rusefi/hellen121vag/README.md

A member of [Hellen ECU family](https://github.com/andreika-git/hellen-one) for [rusEFI firmware](https://github.com/rusefi/rusefi).

[User Documentation](https://github.com/rusefi/rusefi/wiki/Hellen121VAG)

ME 7.5
