rusefi/hellen121vag/boards/hellen121vag-a/board/misc/hellen121vag-a-bottom.png

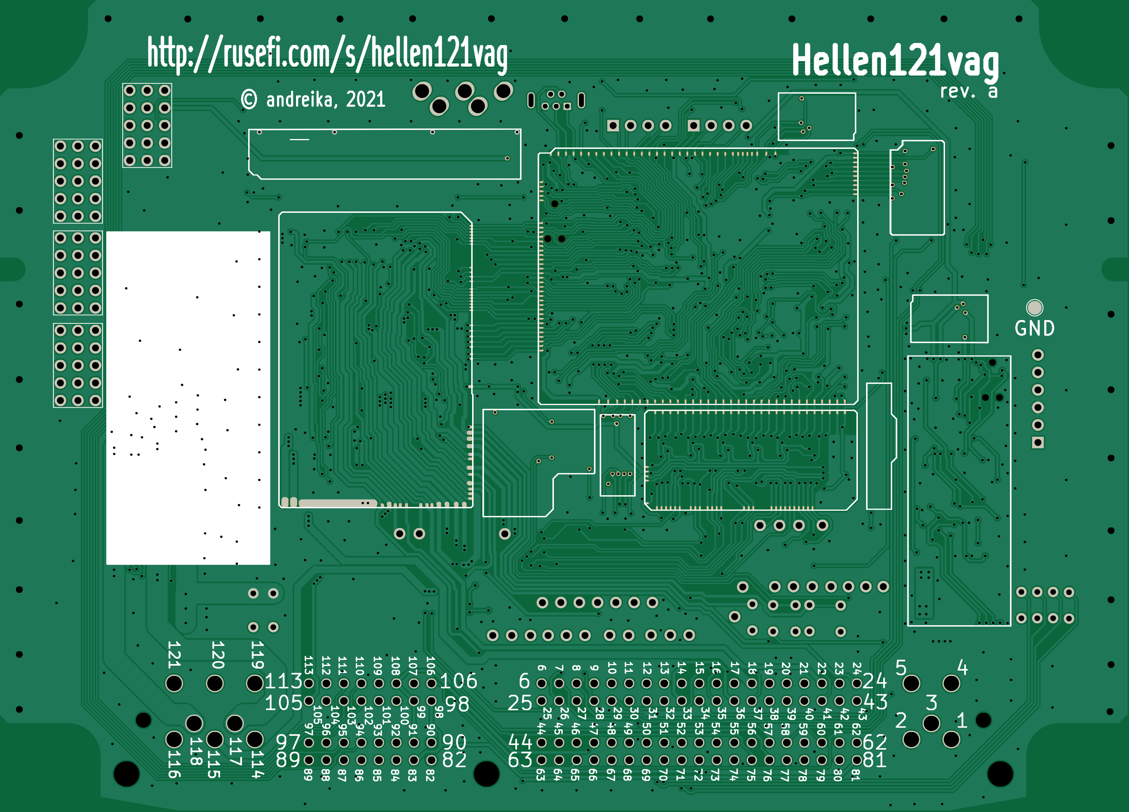
boards/hellen121vag-a/board/misc/hellen121vag-a-bottom.png
