rusefi/hellen121vag/boards/hellen121vag-a/board/Produce_DanZhi.SMT_Original_Snapshot.Top.2582135A_Y99.SMT0210502188446.png

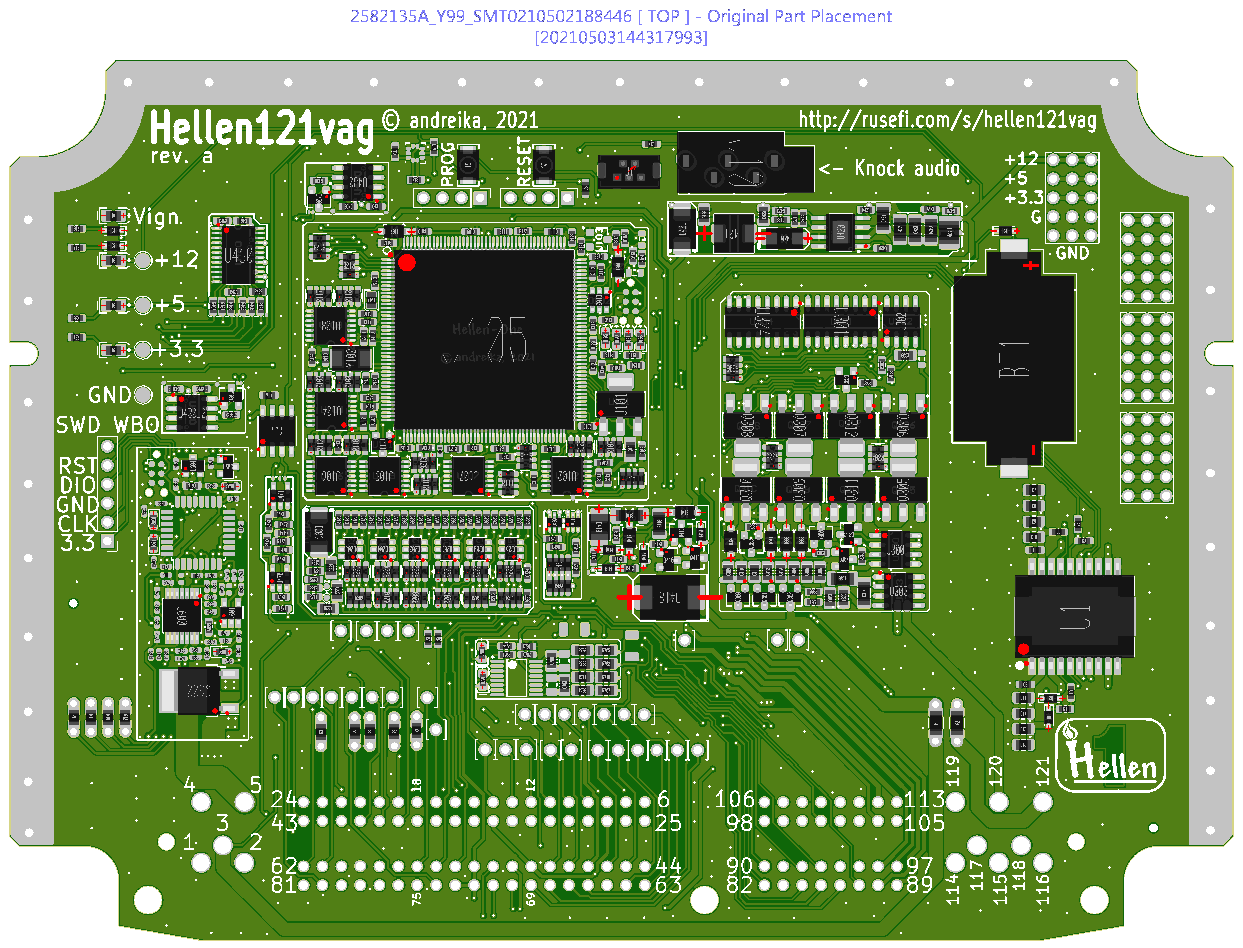
boards/hellen121vag-a/board/Produce_DanZhi.SMT_Original_Snapshot.Top.2582135A_Y99.SMT0210502188446.png
