rusefi/hellen121vag/boards/hellen121vag-b/board/hellen121vag-b.png

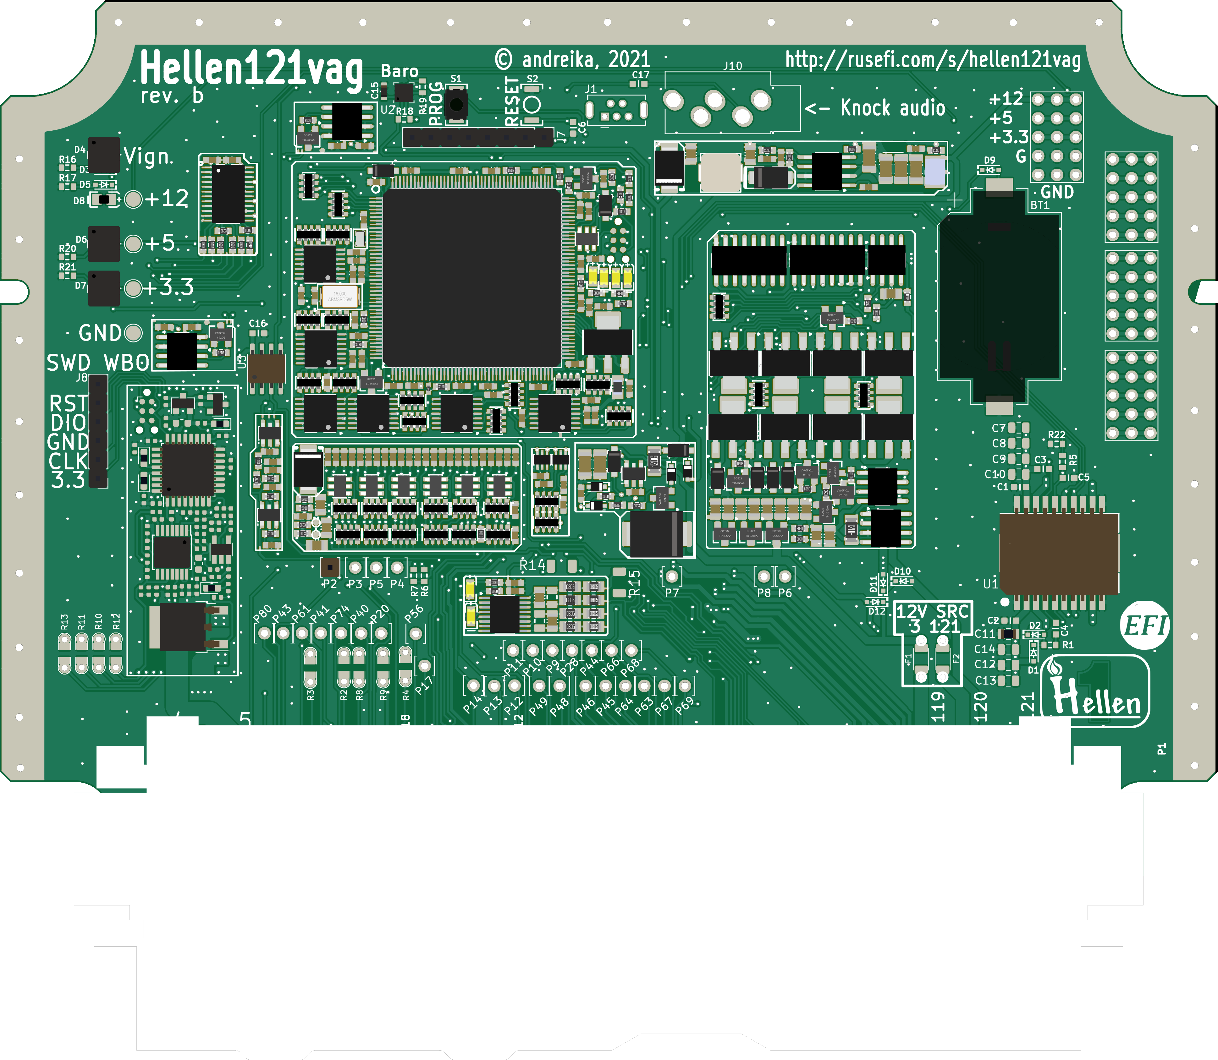
boards/hellen121vag-b/board/hellen121vag-b.png
