rusefi/hellen121vag/boards/hellen121vag-b/board/misc/hellen121vag-b-outline.png

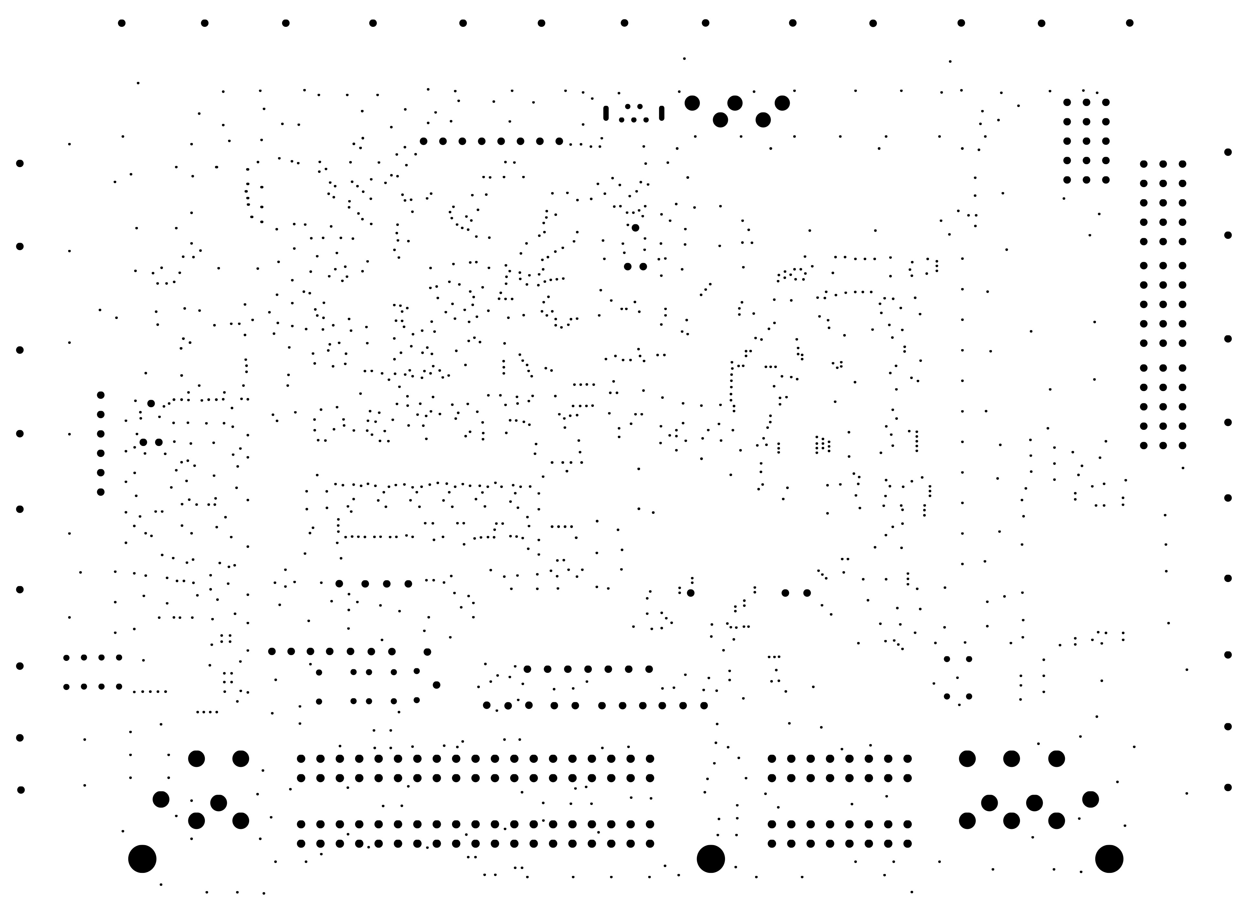
boards/hellen121vag-b/board/misc/hellen121vag-b-outline.png
