rusefi/hellen121vag/boards/hellen121vag-b/board/Produce_DanZhi.SMT_Snapshot.Top.2582135A_Y102.SMT0210614213996.png

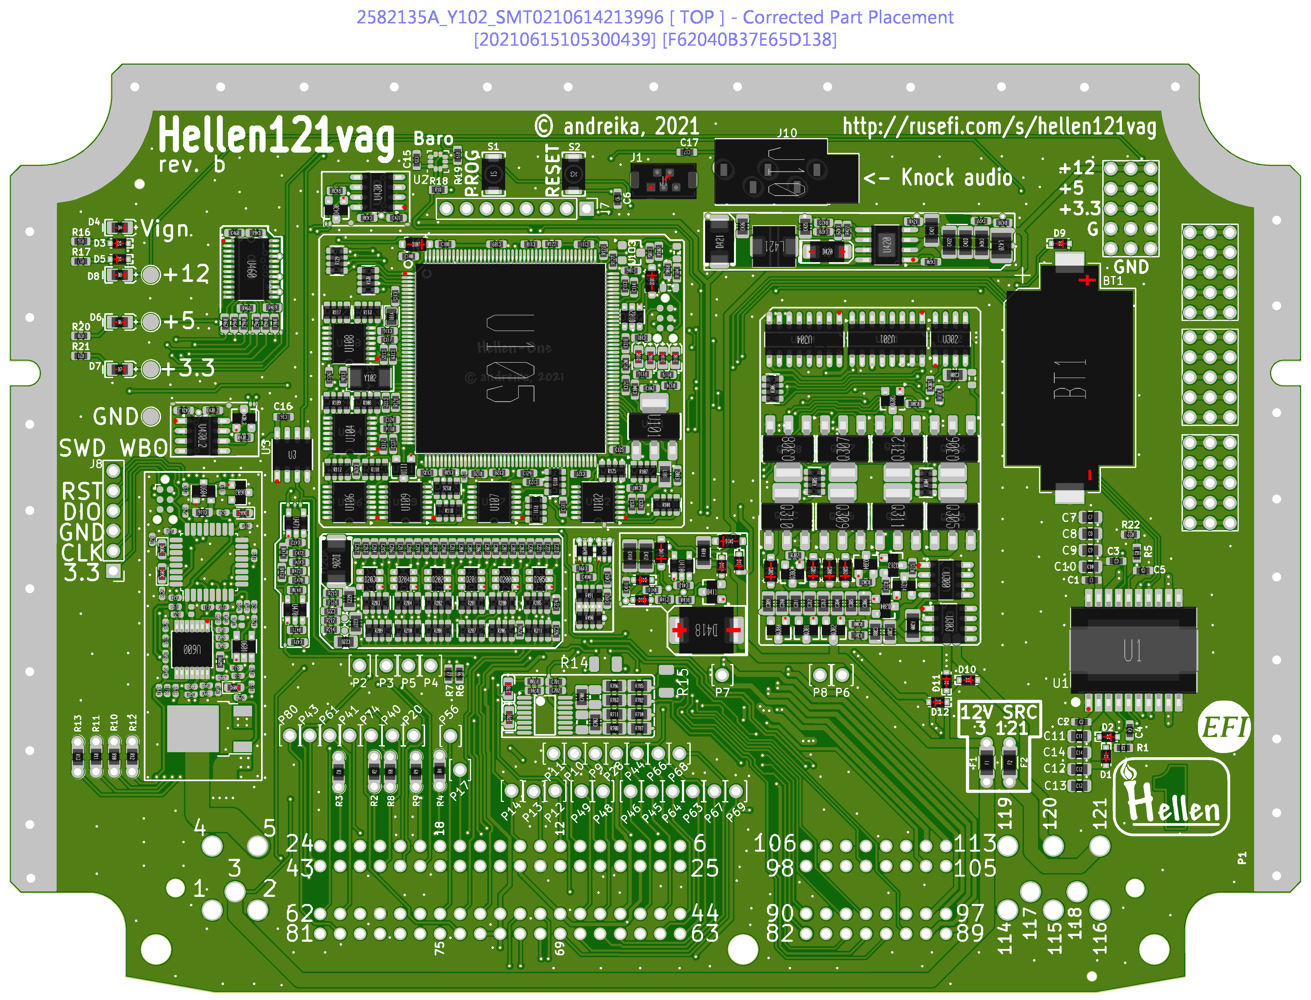
boards/hellen121vag-b/board/Produce_DanZhi.SMT_Snapshot.Top.2582135A_Y102.SMT0210614213996.png
