rusefi/hellen121vag/boards/hellen121vag-c/board/hellen121vag-c.png

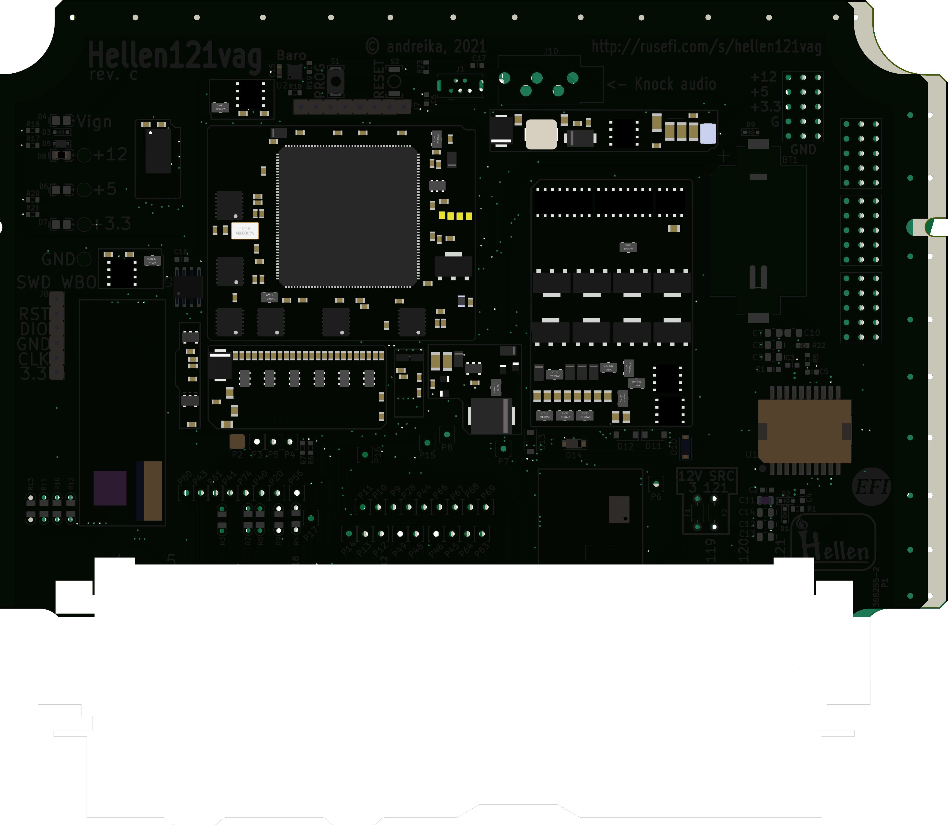
boards/hellen121vag-c/board/hellen121vag-c.png
