rusefi/hellen121vag/boards/hellen121vag-c/board/misc/hellen121vag-c-top.png

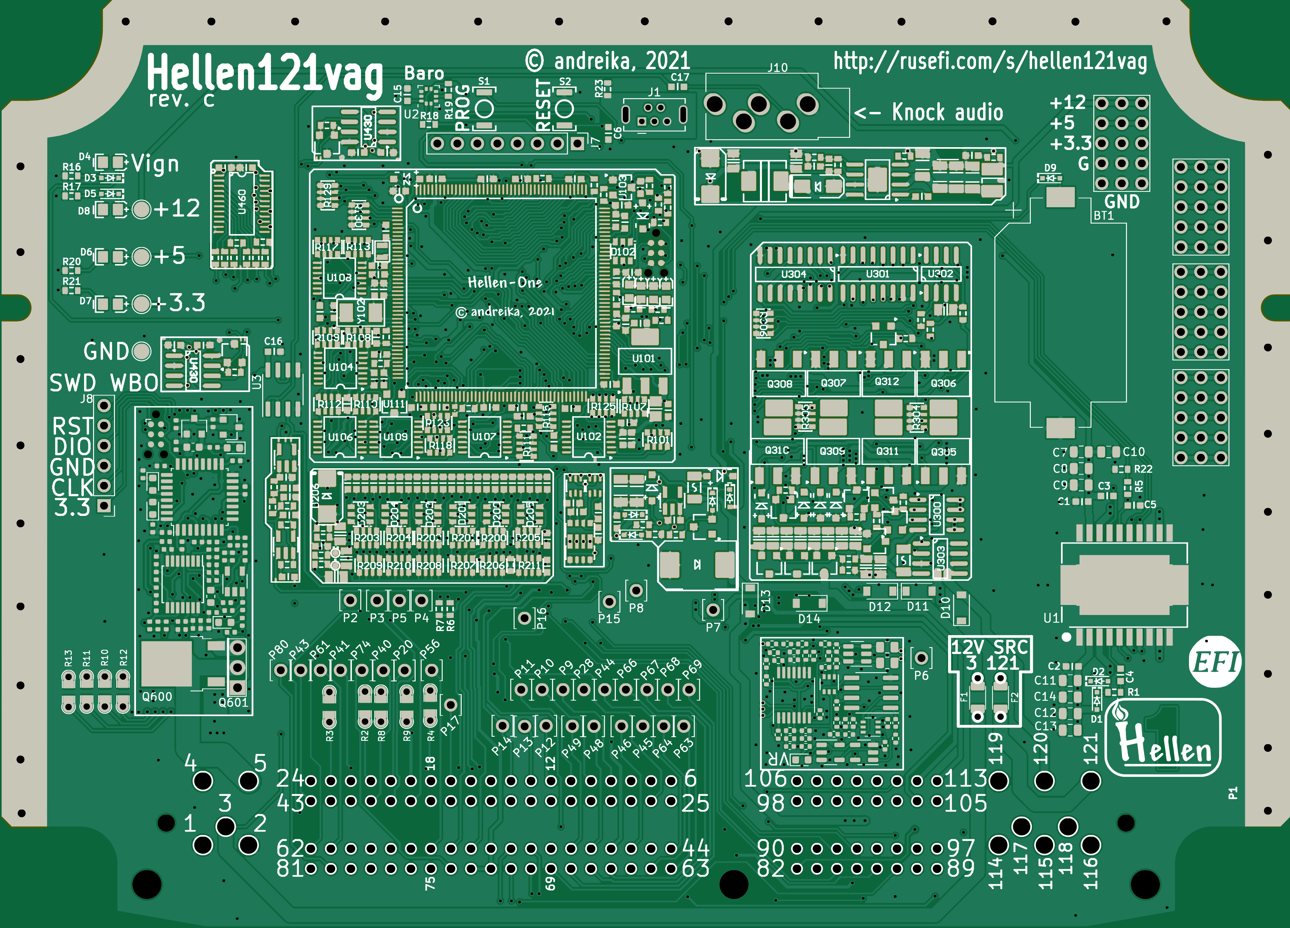
boards/hellen121vag-c/board/misc/hellen121vag-c-top.png
