rusefi/hellen121vag/boards/hellen121vag-c/board/Produce_DanZhi.SMT_Original_Snapshot.Top.211012.png

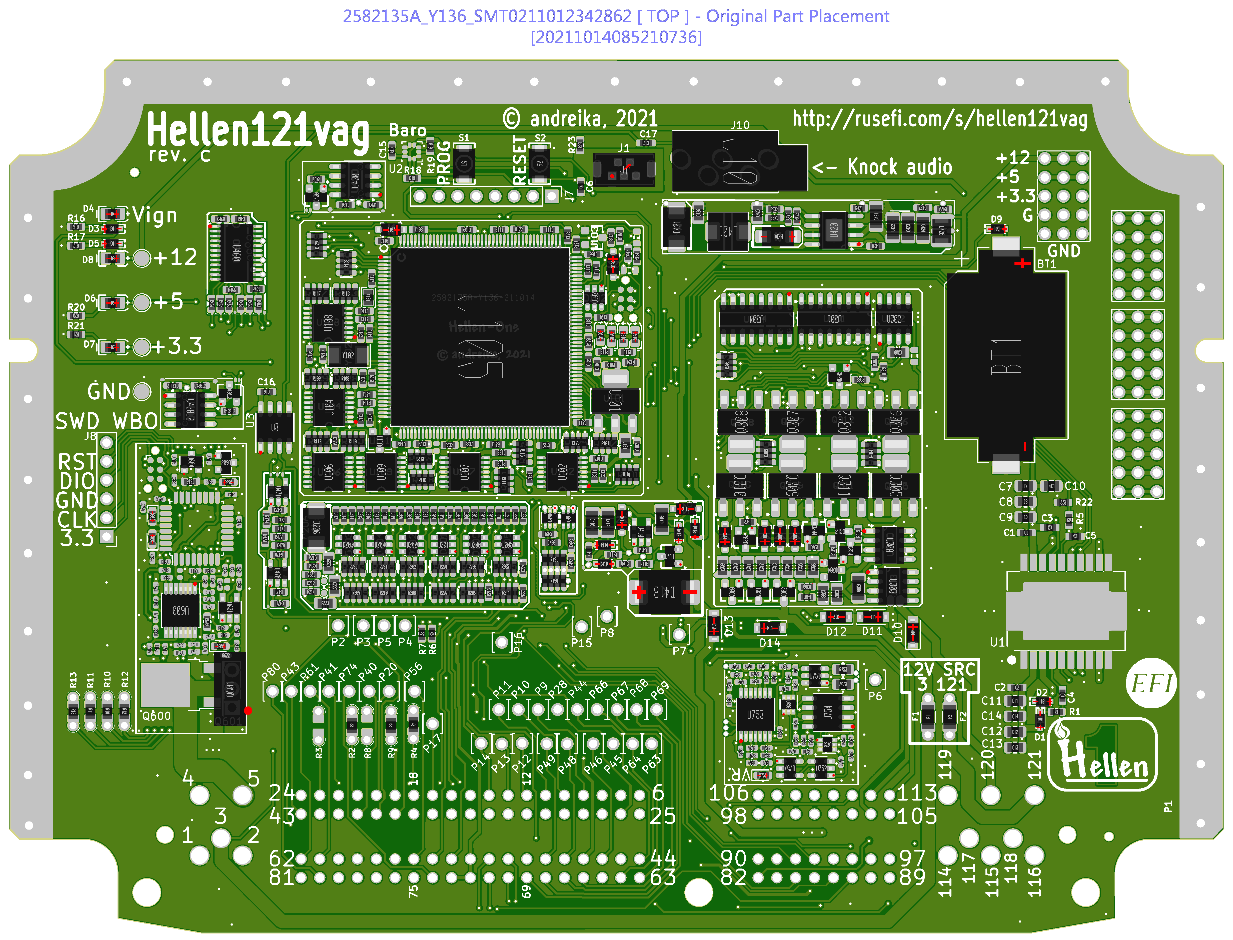
boards/hellen121vag-c/board/Produce_DanZhi.SMT_Original_Snapshot.Top.211012.png
