rusefi/hellen121vag/boards/hellen121vag-b/board/hellen121vag-b-BOM.14june2021.csv

Comment | Designator | Footprint | LCSC Part #
BATTERY_CR2032 | BT1 | BATTERY-2032 | C70377
100n | C1, C2, C6, C15, C16, C430, C431, C420, C101, C105, C106, C107, C108, C109, C110, C111, C112, C113, C117, C118, C119, C120, C121, C122, C123, C124, C125, C126, C127, C128, C129, C130, C135, C139, C204, C205, C206, C207, C212, C213, C214, C215, C220, C221, C222, C223, C224, C225, C226, C470, C460, C461, C411, C413, C430_2, C431_2, C702 | C0603 | C14663
220n | C3 | C0603 | C21120
10n | C4 | C0603 | C100042
5.6n | C5 | C0603 | C170143
10u | C7, C8, C9, C10, C11, C12, C13, C14, C425, C426, C300, C304, C305, C306, C307, C308, C309, C310, C311, C312, C313 | C0805 | C15850
10u | C17, C701 | C0603 | C19702
1N4148WS | D1, D2, D3, D5, D9, D10, D11, D12, D410, D412, D413, D414 | SOD-323 | C2128
LED-GREEN-0805 | D4, D6, D7, D8 | LED-0805 | C2297
Fuse-Pad-Pad | F1, F2 | PAD-1206-PAD | C182446
PROTO_AREA | G1 | PROTO_AREA
PROTO_AREA | G2 | PROTO_AREA
PROTO_AREA | G3 | PROTO_AREA
DISCLAIMER | G4 | Off_Road_Disclaimer
PROTO_AREA | G5 | PROTO_AREA
LOGO | G6 | LOGO
LOGO | G7 | LOGO
USB_B_Mini | J1 | USB-MINI-B-VERTICAL | C13453
Conn_01x01 | J2 | TestPoint_Pad_D2.0mm
Conn_01x01 | J3 | TestPoint_Pad_D2.0mm
Conn_01x01 | J4 | TestPoint_Pad_D2.0mm
Conn_01x01 | J5 | TestPoint_Pad_D2.0mm
Conn_01x01 | J6 | TestPoint_Pad_D2.0mm
Conn_01x08 | J7 | PinHeader_1x08_P2.54mm_Vertical
Conn_01x06 | J8 | PinHeader_1x06_P2.54mm_Vertical
AudioJack_THR | J10 | Jack_3.5mm_PJ-3250-5A | C165947
368255-2 | P1 | 368255-2
Pad | P2 | PAD-TH
Pad | P3 | PAD-TH
Pad | P4 | PAD-TH
Pad | P5 | PAD-TH
Pad | P6 | PAD-TH
Pad | P7 | PAD-TH
Pad | P8 | PAD-TH
Pad | P9 | PAD-TH
Pad | P10 | PAD-TH
Pad | P11 | PAD-TH
Pad | P12 | PAD-TH
Pad | P13 | PAD-TH
Pad | P14 | PAD-TH
Pad | P17 | PAD-TH
Pad | P20 | PAD-TH
Pad | P28 | PAD-TH
Pad | P40 | PAD-TH
Pad | P41 | PAD-TH
Pad | P43 | PAD-TH
Pad | P44 | PAD-TH
Pad | P45 | PAD-TH
Pad | P46 | PAD-TH
Pad | P48 | PAD-TH
Pad | P49 | PAD-TH
Pad | P56 | PAD-TH
Pad | P61 | PAD-TH
Pad | P63 | PAD-TH
Pad | P64 | PAD-TH
Pad | P66 | PAD-TH
Pad | P67 | PAD-TH
Pad | P68 | PAD-TH
Pad | P69 | PAD-TH
Pad | P74 | PAD-TH
Pad | P80 | PAD-TH
100 | R1, R104, R106 | R0603 | C22775
Jumper-Pad-Pad | R2, R4, R9, R10, R11, R12, R13 | PAD-0805-PAD | C17477
Jumper-Pad-Pad | R3, R8 | PAD-0805-PAD | C17477
100k | R5, R471, R473 | R0603 | C25803
2.7k | R6, R7 | R0603 | C13167
DNP | R14 | R1206
DNP | R15 | R1206
5.1k | R16, R17 | R0603 | C23186
4.7k | R18, R19, R302, R303, R307, R308, R313 | R0603 | C23162
1.6k | R20 | R0603 | C22847
750 | R21 | R0603 | C23241
10k | R22, R421, R102, R121, R122, R123, R127, R128, R300, R301, R315, R700, R701 | R0603 | C25804
Button_SPST | S1, S2 | SMD-2_2.9x3.9x1.7 | C115357
L6205PD | U1 | SO20POWER | C36543
LPS25HB | U2 | HLGA-10 | C87898
MCP6002-xSN | U3 | SO8 | C7377
PESD1CAN | D430, D430_2 | SOT-23 | C343993
120 | R430, R430_2 | R0603 | C22787
TJA1051T/3/1J | U430, U430_2 | SO8 | C38695
10u | C421, C422, C423, C424 | C1206 | C13585
4.7u | C427, C102, C103, C104, C137, C138, C140, C616 | C0603 | C19666
10n | C428, C201, C208, C209, C210, C211 | C0603 | C57112
220p | C429 | C0603 | C1603
SS34 | D420 | SMA | C8678
P6SMB6.8CA | D421, D206 | SMB | C78395
2.2uH | L420 | L1210 | C89016
1 | R420 | R0603 | C22936
68k | R422 | R0603 | C23231
12k | R423, R472 | R0603 | C22790
2.2u | C114, C131 | C0603 | C23630
12p | C115, C116 | C0603 | C38523
18p | C132, C136 | C0603 | C1647
B5819W | D101, D107, D300, D301, D302, D303, D416, D417 | SOD-123 | C8598
SRV05-4-P-T7 | D102, D200, D201, D202, D203, D204, D205 | SOT23-6 | C85364
LED-RED-0603 | D103, D600, D603, D700, D701 | LED-0603 | C2286
LED-GREEN-0603 | D104, D601 | LED-0603 | C72043
LED-BLUE-0603 | D105, D602 | LED-0603 | C72041
LED-YELLOW-0603 | D106 | LED-0603 | C72038
SDFL2012Q3R3KTF | L101 | L0805 | C51725
4.7k | R101, R107, R108, R109, R110, R111, R112, R113, R115, R117, R118, R125, R126 | R0603-4 | C66697
47 | R114 | R0603 | C23182
510 | R116, R119, R120, R124, R212, R213, R214, R215 | R0603 | C23193
10k | R129, R130, R208, R210, R304, R305, R306, R491 | R0603-4 | C29718
0 | R131 | R0402 | C17168
AMS1117-3.3 | U101 | SOT-223 | C6186
LMV324IPWR | U102, U104, U106, U107, U108, U109 | TSSOP14 | C398929
AP2337SA-7 | U103 | SOT-23 | C150497
XC6206P332MR | U111, U604 | SOT-23 | C5446
32.768 kHz | Y101 | SMD2012 | C99009
8.0 MHz | Y102 | SMD5032 | C115962
1n | C200, C202, C203, C216, C217, C218, C219, C490, C491, C492, C493 | C0603 | C1588
2.2u | C227, C228, C229 | C0805 | C49217
4.7k | R200, R201, R202, R203, R204, R205, R207 | R0603-4 | C1980
680k | R206, R209, R211, R490 | R0603-4 | C145776
3.3k | R216 | R0603 | C22978
3.3n | C471 | C0603 | C1613
330p | C472 | C0603 | C1664
47p | C473 | C0603 | C1671
680p | C474 | C0603 | C1630
470k | R470 | R0603 | C23178
33k | R474, R411 | R0603 | C4216
LMV321IDBVR | U470, U471 | SOT23-5 | C7972
PSM712-LF | D304, D305, D411 | SOT-23 | C32677
PJM2319PSA | Q300, Q301, Q302, Q303, Q304, Q313, Q314 | SOT-23 | C411720
0 | R310 | R0603 | C21189
RZ7899 | U300, U303 | SO8 | C92373
ULN2003AD | U301, U304 | SOIC16 | C7512
TC4427 | U302 | SO8 | C20551
10 | R461, R462, R463, R464, R466, R467, R468, R469 | R0603 | C22859
SN74LVC4245APWR | U460 | TSSOP24 | C7859
47u | C410, C412 | C1206 | C96123
SMCJ30A | D418 | SMC | C310046
6.8k | R410, R413 | R0603 | C23212
MIC5205-3.3YM5 | U410 | SOT23-5 | C37970
1u | C600, C607, C609, C610, C611 | C0402 | C52923
100n | C601, C602, C605, C608, C612, C613, C614, C615 | C0402 | C1525
33n | C603 | C0402 | C1585
DNP | C604 | C0402
DNP | C606 | C0402
BTS3028 | Q600 | DPAK | C112639
1k | R600, R601, R616, R617, R622, R626, R627, R628 | R0402 | C11702
68k | R602, R603 | R0402 | C36871
10k | R604, R605, R613, R614, R618, R619, R625 | R0402 | C25744
10 | R606 | R0402 | C25077
22k | R607 | R0402 | C25768
47 | R608 | R0402 | C25118
61.9 | R609 | R0603 | C23092
20k | R610, R611, R612 | R0402 | C25765
100k | R615, R621 | R0402 | C25741
27k | R620, R623 | R0402 | C25771
3.3k | R624 | R0402 | C25890
MCP6004 | U600 | TSSOP14 | C50282
AD8628 | U601 | TSOT23-5 | C29309
STM32F042K6Tx | U602 | LQFP32 | C69216
1n | C700, C703 | C0805 | C46653
5.1k | R702, R703, R705, R706, R707, R708, R710, R711 | R0805 | C27834
MAX9926 | U700 | QSOP16
74HC2G17GW | U490, U491 | SOT-363 | C94189
STM32F407IGT6 | U105 | LQFP176 | C33993
MWSA0503S-100MT | L421 | SMD-5.2x5.4x2.8 | C408412
LMR14030 | U420 | SOP8 | C182078
ZXMS6005SGTA | Q305, Q306, Q307, Q308, Q309, Q310, Q311, Q312 | SOT-223 | C174042
nSMD050-24V | F410, F300 | F1206 | C70076
REF3333AIDBZR | U603 | SOT-23 | C130016
