rusefi/hellen121vag/boards/hellen121vag-b/board/misc/hellen121vag-b-components.png

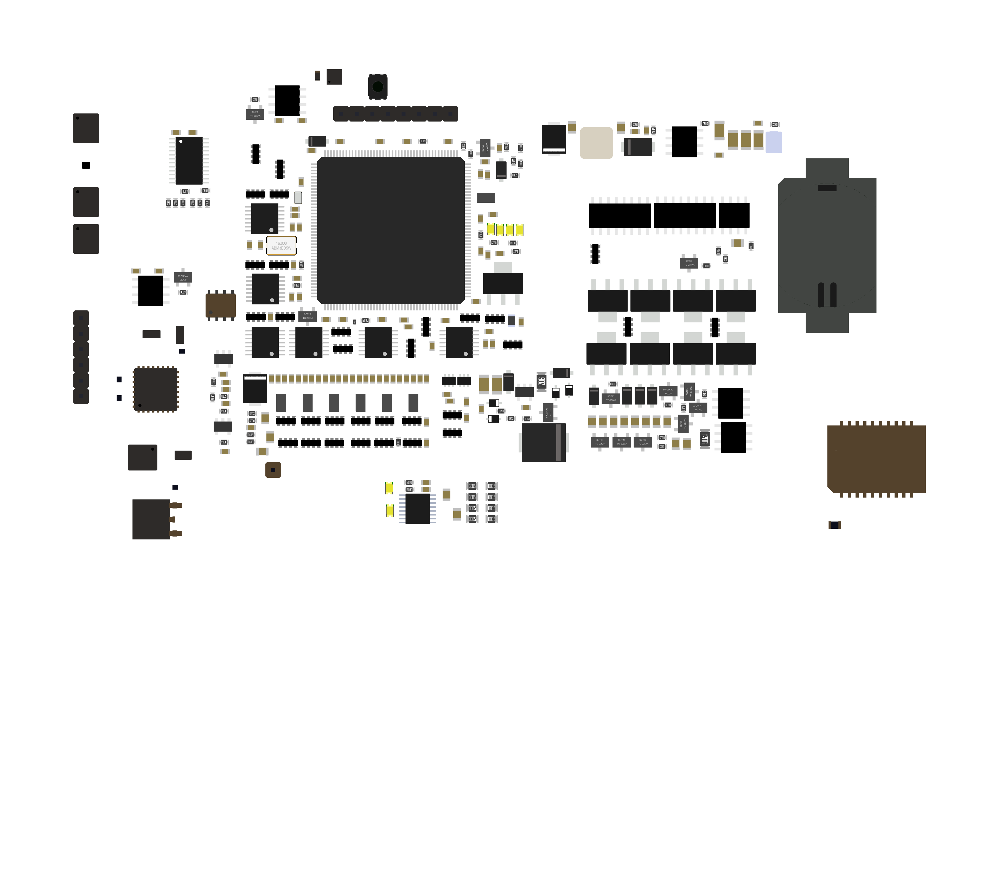
boards/hellen121vag-b/board/misc/hellen121vag-b-components.png
