rusefi/hellen121vag/boards/hellen121vag-c/board/misc/hellen121vag-c-components.png

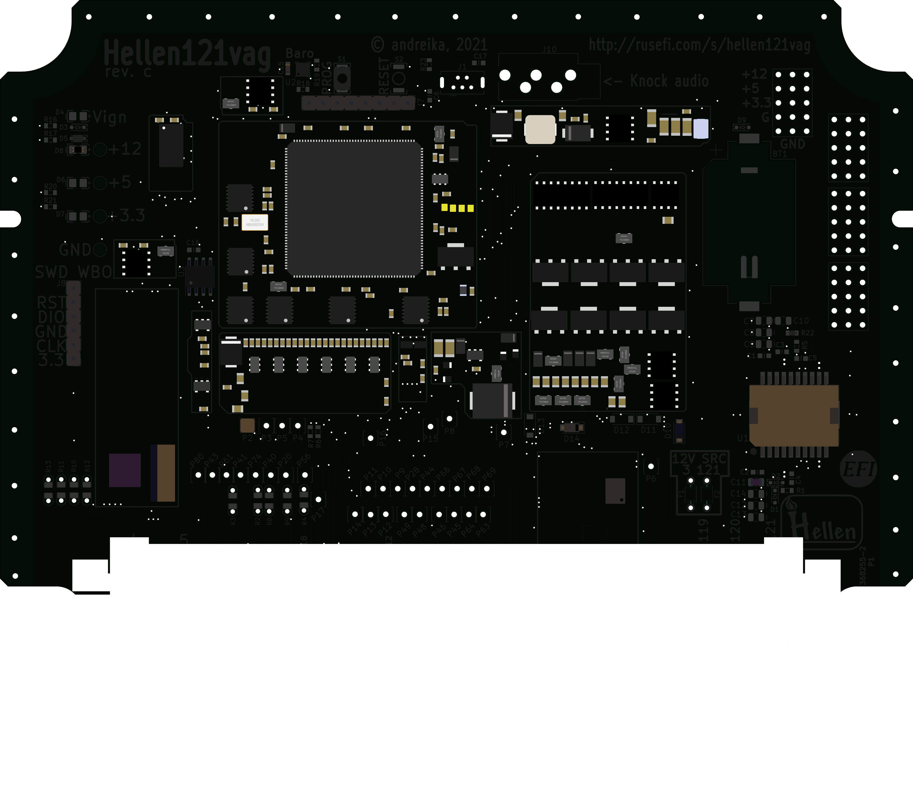
boards/hellen121vag-c/board/misc/hellen121vag-c-components.png
