rusefi/hellen121vag/releaseNotes.md

rev C:
    Crank/cam test points
    improved routing
    discrete VR 

rev B: 2021
    CLT/IAT pull-up fix

rev A: May 2, 2021
    Initial release
