rusefi/hellen121vag/(threads)

Thread 1 (2021-02-04):

WBO analysis

rusefillc, 2021-02-04:
Question: what cases do we have on VAG in terms of number of narrow band sensors and number of wide band sensors per vehicle?

Is there a clearly universal set of pins for a wideband or would we have to have options and jumpers?

rusefillc, 2021-03-08:
nice diagrams do not spell which pin is what function of WBO :(

https://github.com/rusefi/rusefi/wiki/OEM-Docs/VAG/2005_a4_1.8t_1.png

https://github.com/rusefi/rusefi/wiki/OEM-Docs/VAG/2005_a4_1.8t_2.png

https://github.com/rusefi/rusefi/wiki/OEM-Docs/VAG/2005_a4_1.8t_3.png

rusefillc, 2021-03-09:
Damn it's 4.2 :(

See https://rusefi.com/forum/viewtopic.php?p=40079#p40079

rusefillc, 2021-06-13:
@mck1117 any chance to have https://github.com/mck1117/wideband/issues/7 ?

if not we should add an un-populated jumper to make the board safer on arrival

rusefillc, 2021-06-15:
Status update: we know 4.2 pinout but we do not have 4.2 firmware

rusefillc, 2022-10-14:
@mck1117 @dron0gus where shall we place what unpopulated jumper to make the board safer while no 4.2 firmware?

mck1117, 2022-10-17:
do we need to? the existing controller hw+sw will not hurt a 4.2 sensor, it just won't work

Thread 5 (2021-02-19):

short URL label

rusefillc, 2021-02-19:
please place http://rusefi.com/s/hellen121vag on the board

Closed 2021-02-21.

Thread 8 (2021-03-12):

This board uses module rotation

andreika-git, 2021-03-12:
We need to implement module rotation in Hellen-One scripts in order to produce this board.
See https://github.com/andreika-git/hellen-one/issues/16

rusefillc, 2021-04-11:
This was fixed by https://github.com/andreika-git/hellen-one/issues/16

Closed 2021-04-11.

Thread 9 (2021-03-15):

hellen121vag rev A roadmap

rusefillc, 2021-03-15:
What would need to happen for us to publish hellen121vag gerbers?

rusefillc, 2021-05-02:
Sent to fab

known issues: WBO firmware needs 4.2 mode https://github.com/mck1117/wideband/issues/7

Closed 2021-06-13.

Thread 10 (2021-04-10):

Usability: silk, LEDs, test pads

rusefillc, 2021-04-10:

rusefillc, 2021-04-25:
@Qwerty-OFF what can we and what can we not do here? can we have GND test pad on the back? etc

rusefillc, 2021-04-27:
Looks good

Closed 2021-04-27.

Thread 15 (2021-04-11):

main connector would so much more readable if not at 90 degrees

rusefillc, 2021-04-11:
at the moment on the schematics main connectors forces me to tilt my head to read pins, that's not comfortable

please turn main connector on schematics so that pins read normal horisonal

Qwerty-OFF, 2021-04-16:
Done

Closed 2021-04-16.

Thread 16 (2021-04-14):

need larger more trustworthy ETB driver

rusefillc, 2021-04-14:
See https://github.com/andreika-git/hellen-one/issues/28

rusefillc, 2021-04-14:
That's about
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

Please rename network names

rusefillc, 2021-04-16:
Let's go with L6205

Qwerty-OFF, 2021-04-17:
Done

Closed 2021-04-17.

Thread 17 (2021-04-17):

backup onboard power

rusefillc, 2021-04-17:
is there a better way than our current huge battery holder with the risk of battery flying around inside the ECU?

Qwerty-OFF, 2021-04-24:
Placed cr2032 battery holder

Closed 2021-04-24.

Thread 19 (2021-04-23):

Add baro sensor

rusefillc, 2021-04-23:

rusefillc, 2021-04-23:
Relates to https://github.com/rusefi/rusefi/issues/2288

Qwerty-OFF, 2021-04-24:
Done

Closed 2021-04-24.

Thread 21 (2021-04-30):

3v 5v LED resistor values

rusefillc, 2021-04-30:
see https://github.com/rusefi/hellen64_miataNA6_94/issues/32

see https://github.com/andreika-git/hellen-one/issues/30

Qwerty-OFF, 2021-05-01:
Done

Closed 2021-05-01.

Thread 24 (2021-05-01):

Test order attempt

rusefillc, 2021-05-01:
U103 | AP2331W-7 | SC59 | Diodes Incorporated AP2331W-7Extended PartSC-59C460346 | 1 | $0.1329 | Inventory shortage
-- | -- | -- | -- | -- | -- | --

Q300,Q301,Q302,Q303,Q304 | AO3401A | SOT-23 | No part selected
-- | -- | -- | --

U430,U430_2 | TJA1051T/3/1J | SO8 | No part selected
-- | -- | -- | --

rusefillc, 2021-05-01:
AO3401A -> C347476
TJA1051T -> C92211

Qwerty-OFF, 2021-05-01:
Fixed:
> AO3401A -> C347476
> TJA1051T -> C92211

we use a diode because we did not find a replacement for AP2113 on JLC

Closed 2021-05-01.

Thread 25 (2021-05-02):

Cam and crank sniffing vias

rusefillc, 2021-05-02:
As of today we do not have super reliable way to record digital trigger inputs. For right now the best way to troubleshoot anything related to trigger would be hooking up an external logic ananlyzer device between cam/crank signal conditioning and MCU.

We need a via on both cam and crank MCU traces to allow soldering of a pin for external logic analyzer.

Qwerty-OFF, 2021-06-05:
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

Closed 2021-06-05.

Thread 26 (2021-05-02):

connector yaml mapping file

rusefillc, 2021-05-02:
Need help entering data into https://github.com/rusefi/rusefi/blob/master/firmware/config/boards/hellen/hellen121vag/connectors/main.yaml so that generated https://rusefi.com/docs/pinouts/hellen/hellen121vag/ has the pinout info

For reference see https://rusefi.com/docs/pinouts/hellen/hellen64_miataNA6_94/ and https://rusefi.com/docs/pinouts/hellen/hellen72/ created based on https://github.com/rusefi/rusefi/blob/master/firmware/config/boards/hellen/hellen64_miataNA6_94/connectors/main.yaml and https://github.com/rusefi/rusefi/blob/master/firmware/config/boards/hellen/hellen72/connectors/main.yaml

rusefillc, 2021-05-10:
@ksmola see https://github.com/rusefi/rusefi/wiki/Connector-Mapping

rusefillc, 2021-05-13:
See also https://github.com/rusefi/rusefi/issues/2385

rusefillc, 2021-05-13:
121vag user documentation and schematics

https://github.com/rusefi/rusefi/wiki/Hellen121VAG

rusefillc, 2021-05-21:
And we are done!

Closed 2021-05-21.

Thread 27 (2021-05-06):

diode for vvt and idle outputs

rusefillc, 2021-05-06:
See https://github.com/andreika-git/hellen-one/issues/40

andreika-git, 2021-05-06:
Hellen121vag has 2 vvts. and both don't use external mosfets at all, not to speak of diodes.
The first one uses 1A double ls-outputs, the second one uses "middle-power" solenoid push-pull drivers.

Qwerty-OFF, 2021-06-05:
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

Closed 2021-06-05.

Thread 30 (2021-05-19):

Put mission statement right on the board silkscreen

rusefillc, 2021-05-19:
Back side silk:

"Always looking for C/C++/PHP/Java developers
https://rusefi.com/s/mission"

rusefillc, 2021-06-11:
https://github.com/rusefi/hellen154vag-9.1/issues/7

Qwerty-OFF, 2021-06-13:
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

Closed 2021-06-13.

Thread 32 (2021-05-20):

less crazy routing for ignition outputs

mck1117, 2021-05-20:
maybe put ignition driver module closer to output pins, instead of routing the ignition output signals half way around the board like this:

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

rusefillc, 2021-05-20:
Maybe time to 4 layer?

mck1117, 2021-05-20:
I mean move the module.  The routing is fine, I'd just rather not have "outside world" signals making a huge loop area.  Much better to locate the potentially noisy drivers close to the plug, instead of clear across the board.

mck1117, 2021-06-14:
poke?

rusefillc, 2021-06-14:
We will have a bigger change with rev C while adding SD card

rusefillc, 2021-08-24:
pictured U460 is the ignition module piece

Closed 2021-09-08.

Thread 33 (2021-05-28):

[safety] Add pulldown to L6205 enable line

rusefillc, 2021-05-28:
Add a pulldown resistor to L6205 enable. If the STM32 pin floats (reset, programming, during init, etc), the ETB driver must be disabled.

Also, remove R47. No need for a series resistor.

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

Qwerty-OFF, 2021-06-05:
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

Closed 2021-06-05.

Thread 37 (2021-06-05):

Please add words

rusefillc, 2021-06-05:
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

PUMP -> Fuel Pump Relay
MAIN -> Main Relay
CE -> Radiator Fan
OUT_CE -> OUT_RADIATOR_FAN

Open question if we need a unified language for many Hellen or if we shall use the naming convention of the specific vehicle or both

rusefillc, 2021-06-05:
@andreika-git says that CE is check engine

Qwerty-OFF, 2021-06-05:
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

Closed 2021-06-05.

Thread 38 (2021-06-05):

Main Relay Output confusion episode #1

rusefillc, 2021-06-05:
R2 wires main relay output to pin 21
R3 wires main relay output to pin 23

Pavel X-Service complaints that pin 21 is low regardless of ECU running or not.

https://github.com/rusefi/rusefi/wiki/Hellen121VAG#vehicle-specific-jumpers

Closed 2021-06-13.

Thread 39 (2021-06-08):

Remove Q313 from rev A pieces

rusefillc, 2021-06-08:
From power supply of all five boards we need to remove Q301 same as

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

@kon please mod your board

rusefillc, 2021-06-08:
@mck1117 please mod the board in your possession

mck1117, 2021-06-09:
done

Qwerty-OFF, 2021-06-13:
Fixed in output-0.2

Closed 2021-10-01.

Thread 40 (2021-06-08):

Document F1/F2

rusefillc, 2021-06-08:
F1/F2 seems to be similar to R2 R3 R8 R9

I think we shall document R2/R3/R8/R9 meaning with a bit of text right on PCB?

rusefillc, 2021-06-08:
also open question of we can put any relevant text right on the PCB or not even bother?

@Qwerty-OFF maybe F1 can say "from 121" and F2 can say "from blah blah" etc? R2 could say "MR to 21"?

andreika-git, 2021-06-09:
First attempt to add F1/F2 jumpers to the H121vag wiki page:
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

Qwerty-OFF, 2021-06-09:
We can do something like this if we need and have enogh space on the board
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

rusefillc, 2021-06-11:
Looks great!

Closed 2021-06-11.

Thread 41 (2021-06-08):

TPS calibration drama

rusefillc, 2021-06-08:
is it about op-amp PNs?

Matthew Kennedy  1:27 PM
You've been struck by the woes of the LMV324

1:27
This is why we need MCP6004

Matthew Kennedy  1:35 PM
which is...unfortunate
1:35
it means ETB probably won't work without replacing those opamps

mck1117, 2021-06-08:
see https://github.com/andreika-git/hellen-one/issues/27 and https://github.com/andreika-git/hellen-one/issues/63

I ran in to exactly the same problem when using a Proteus with LMV324 on my car.  Replaced with MCP6004, problem solved.

rusefillc, 2021-06-09:
Less rail to rail comparing with 6004

mck1117, 2021-06-09:
@dron0gus LMV324 Output swing only goes from 0.05 to 4.45 volts.  MCP6004 output swing goes from 0.002 to 4.985 volts.

dron0gus, 2021-06-10:
@mck1117 thanks.
I'm using -0.6V and +5.5V to power OpAmps on my custom board. Looks like this saved me some time debuging similar issues.

Closed 2021-06-11.

Thread 42 (2021-06-08):

WBO VN1160 not acceptable

mck1117, 2021-06-08:
VN1160 doesn't work. I don't know why this chip was chosen.

Qwerty-OFF, 2021-06-09:
https://github.com/rusefi/hellen64_miataNA6_94/issues/54#issuecomment-857916625

rusefillc, 2021-06-10:
Dron_Gus  5:57 AM
@Matthew Kennedy can I replace smart mosfet in WBO with simple N-channel mosfet?
5:57
like IPD079N06 or STD25NF10

Matthew Kennedy  1:08 PM
I think it would work, but you get no protection against short circuit or anything

rusefillc, 2021-06-10:
@mck1117 can you please remove wrong part from your hellen?
@mck1117 do you have a part to install on your hellen 121?

@kon please also at least remove the mosfet to reduce confusion

mck1117, 2021-06-10:
Yes, I have a handful of leftover VNS14NV04 from another project, and already swapped one while diagnosing the problem.

BTW: that's the low side driver from Frankenso, if you have a bunch of those sitting around.

rusefillc, 2021-06-13:
@Qwerty-OFF please close once we make BOM change

Closed 2021-06-13.

Thread 43 (2021-06-08):

CLT and IAT should be pulled up not down

rusefillc, 2021-06-08:

rusefillc, 2021-06-09:
@mck1117 @kon please mod the board you have

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

mck1117, 2021-06-09:
done

Qwerty-OFF, 2021-06-09:
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

rusefillc, 2021-06-10:
@andreika-git can you please validate? is there an MCU module pull-up we are supposed to populate or do we just use external resistor?

andreika-git, 2021-06-10:
Ok, here's the full story behind CLT/IAT pullups:

1) We do have the built-in configurable pullup/pulldown resistors for CLT/IAT in the input module. But their value is 4.7k (because it's an average "common good" value for 4 different inputs)

2) Most of the sensors work with 4.7k pullups (or pulldowns) just fine, but some users may still consider this as a limitation of the input module and may want to use their different "better" board-specific values.

3) This also covers the case when the same board may use both pull-up and pull-down for an analog input - depending on specific board configuration.

4) Hellen121vag is an open-source demo board, so I intentionally put those external resistors just to demostrate this possibility, and used "rusefi-legacy" 2.7k values. Especially since so many different VAG configurations exist for the one single board.

5) The only thing left to do was to run through all VAG diagrams and check whether pull-ups or pull-downs are needed for some of them. That was supposed to be a separate task in the TODO list... And that's where the issue came from... :)

6) As for now, I still don't know if these pullups are valid for all VAG configurations. Is we _assume_ they are, then we can just leave the current (fixed) version as is.

mck1117, 2021-06-10:
Another factor is that the resistor arrays are pretty inaccurate, and the pullup accuracy really only matters for temperature sensors.

Closed 2021-06-13.

Thread 48 (2021-07-01):

Implement & Document trigger HW solder hookup pins

rusefillc, 2021-07-01:
Same as hellen72 we need logic level MCU signal hook-up vias

Crank hookup point has to be between VR conditioning and MCU

For example same thing on Hellen 72 board:

P9 & P10 on https://github.com/rusefi/rusefi/wiki/Hardware/Hellen/hellen72-d-schematic.pdf

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

rusefillc, 2021-07-01:
See https://github.com/rusefi/hellenNA6_issues/issues/10
See https://github.com/rusefi/hellen-NB2-issues/issues/3
See https://github.com/rusefi/hellen121nissan-issues/issues/7

rusefillc, 2021-07-30:
https://github.com/rusefi/hellen154hyundai-issues/issues/5

Closed 2021-08-24.

Thread 49 (2021-07-08):

rev B was fabbed with LMV324IPWR

rusefillc, 2021-07-08:
https://github.com/andreika-git/hellen-one/issues/63

rusefillc, 2021-07-08:
https://github.com/rusefi/hellen121vag/blob/main/boards/hellen121vag-b/board/hellen121vag-b-BOM.14june2021.csv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

rusefillc, 2021-07-08:
we need to bump to mcu 0.4

rusefillc, 2021-08-24:
this is about replacing 0.2 with 0.5 every time we reference mcu

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

Thread 52 (2021-07-11):

Just to clarify - where are we with v8 with dual VVT? document current on pins 115 and 120

rusefillc, 2021-07-11:
2003 Audi A6 4.2 has 8 injectors and two VVT actuators, do we support that configuration?

I see
pin 115
low side solenoid (OUT_VVT1_2 = LOW9+LOW12)
pin 120
low side solenoid (OUT_VVT2_2 = OUT_COIL_B2)

I wonder how differently would these control the actuators

Thread 53 (2021-07-11):

Just to clarify - is this board compatible with 2010 TT?

rusefillc, 2021-07-11:
Are we or are we not compatible with https://github.com/rusefi/rusefi/wiki/2010-Audi-TT ?

Qwerty-OFF, 2021-07-12:
Not compatible

Closed 2021-08-24.

Thread 54 (2021-08-01):

Do we really need both channels of L6205 to safely drive ETB?

rusefillc, 2021-08-01:
At the moment we have both channels wired in parallel

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

Is that actually needed?

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

Shall we add 0R jumpers for second channel to experiment?

rusefillc, 2022-10-14:
We've since learned that YES, we need both channels

@Qwerty-OFF please close if current board still uses both channels, no need to swap into TLE9201 yet

Thread 55 (2021-08-06):

QR code silkscreen

rusefillc, 2021-08-06:
Put https://github.com/rusefi/rusefi/blob/master/misc/www/s/hellen121vag/qr-hellen121vag.png on PCB silkscreen back side

rusefillc, 2021-09-19:
See also https://github.com/rusefi/hellen154hyundai/issues/24

rusefillc, 2021-09-19:
https://github.com/rusefi/hellen88bmw/issues/72

rusefillc, 2021-09-19:
https://github.com/rusefi/hellen128merc-issues/issues/28

Thread 58 (2021-08-24):

How does this work? Feature of bug?

rusefillc, 2021-08-24:
why is KiCAD complaining about not connect here?

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

andreika-git, 2021-08-24:
Kicad doesn't know that those pads indide the input modules are already connected internally. Altium has a "jumper" feature to disable the warning, but Kicad does not.

hasl58, 2021-09-07:
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
why pin J1-6 not connect to GND?

rusefillc, 2021-09-07:
https://github.com/rusefi/hellen121vag/issues/62

Thread 59 (2021-08-24):

bump version

rusefillc, 2021-08-24:
PCB version and board silkscreen version should be bumped from "B" to "C"

rusefillc, 2021-09-08:
Once we are done with all changes we need to export gerbers, DRL, BOM, PLC and PDF

https://github.com/andreika-git/hellen-one/wiki/kicad-export-frame

Closed 2021-10-01.

Thread 60 (2021-08-24):

replace VR module with VR-discrete

rusefillc, 2021-08-24:
remove VR module
add VR-discrete like on https://github.com/rusefi/hellen128mercedes
VR_analog should be connected to ADC3 pin, see hellen128merc

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

rusefillc, 2021-08-24:
@mck1117 what is current requirement for THRESHOLD_VR? does it have to a low side channel or could it be just an stm32 pin?

https://github.com/andreika-git/hellen-one/wiki/module-output

mck1117, 2021-08-24:
>  VR_analog not needed

Not true, this will eventually be required for configuration.

> @mck1117 what is current requirement for THRESHOLD_VR? does it have to a low side channel or could it be just an stm32 pin?

It needs a PWM output directly from the MCU, no output module.

rusefillc, 2021-08-24:
@mck1117 please elaborate
"analog" vs "configuration"
does it have to be an ADC pin or just any GPIO pin?

rusefillc, 2021-08-24:
Some notes added to https://github.com/andreika-git/hellen-one/wiki/module-vr-discrete

mck1117, 2021-08-24:
Analog in to the MCU will let you view the waveform from the sensor in real time, so you can set the threshold. Maybe completely automatic in the future.

The analog input to the MCU needs to be something on ADC3.

rusefillc, 2021-08-24:
@mck1117 is there a chance that we are over-engineering here?

mck1117, 2021-08-24:
This would be nice to do, since without the max992x we don't get automagic threshold:

https://www.maxxecu.com/webhelp/settings-diagnostics-trigger_oscilloscope.html

rusefillc, 2021-09-08:
@mck1117 can you please pick where to connect VR_analog on hellen121vag?

rusefillc, 2021-09-15:
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

rusefillc, 2021-09-22:
Looks like depends/related to #49

rusefillc, 2021-09-22:
Since we are removing old VR there is no need in input/output jumpers

rusefillc, 2021-09-22:
VR_THRESHOLD could use any of the GPIO unused pins

E23 E11 etc

mck1117, 2021-09-22:
> VR_THRESHOLD could use any of the GPIO unused pins
>
> E23 E11 etc

No, VR_THRESHOLD needs a hardware PWM pin from the STM32.  It's in theory possible with soft PWM, but faster hardware PWM does make a big difference there.

rusefillc, 2021-09-22:
ok, on this board we can move idle

Closed 2021-10-01.

Thread 61 (2021-08-29):

VVT diode

rusefillc, 2021-08-29:
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

@mck1117 suggests a different VVT diode NOT 1N4148WS "that diode is only rated for 150mA"

worth noting that Miata 64 uses 1N4148WS for IAC and VVT
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

rusefillc, 2021-08-29:
Давай поставим наши любимые B5819W (C8598) 1A rated?

rusefillc, 2021-10-01:
@hasl58 what's the status of this one?

rusefillc, 2021-10-01:
@hasl58 looks like B5819W (C8598) is already used on this board in different spots https://github.com/rusefi/hellen121vag/blob/main/boards/hellen121vag-b/board/hellen121vag-b-BOM.14june2021.csv

rusefillc, 2021-10-09:
@Qwerty-OFF please review

rusefillc, 2021-10-11:
yes please

Thread 62 (2021-09-07):

Connect J1-6 USB cable shield to GND

rusefillc, 2021-09-07:
J1-6 USB cable shield was not connected to GND due to tracing issues with JLC tolerances.

We should connect J1-6 USB cable shield to GND once we migrate board to 4 layers

mck1117, 2021-09-07:
...how was this a problem with JLC tolerance?

The recommendation is not shorting the shield to ground.  On proteus it has a 100n + 100k in parallel to ground.

mck1117, 2021-09-07:
ok looks like there are conflicting opinions in the literature about what's best - let's put an 0603 pad for now with a 0 ohm mounted

hasl58, 2021-09-07:
>>in the literature

link please show

mck1117, 2021-09-07:
https://electronics.stackexchange.com/a/4519

hasl58, 2021-09-07:
if USB 2.0 and less pin6 to GND
if USB 3.0 and large pin6 from resistor

hasl58, 2021-09-07:
ok. i connect through resistor.

rusefillc, 2021-09-07:
@hasl58 what exact lib file would need to be changed? is that some standard library or rusEFI custom library https://github.com/rusefi/kicad-libraries/ ?

if it's https://github.com/rusefi/kicad-libraries/ we would need a pull request into https://github.com/rusefi/kicad-libraries/ - i.e. fork https://github.com/rusefi/kicad-libraries/ and etc same process as PR into this hellen121vag here

Closed 2021-09-08.

Thread 64 (2021-09-14):

Wrong GND plane fills inside 2-sided modules

andreika-git, 2021-09-14:
This will short the vias inside the input module:

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

Closed 2021-10-01.

Thread 65 (2021-09-14):

ibom how do I know which one is U106?

rusefillc, 2021-09-14:
modules do not show silkscreen?

https://rusefi.com/docs/ibom/hellen121vag-b-ibom.html

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

rusefillc, 2021-09-14:
well I found a way

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

but still - do we have a defect of frame silk showing but not module silk?

rusefillc, 2022-06-13:
this is resolved with latest hellen and docker

Closed 2022-06-13.

Thread 68 (2021-09-29):

migrate to WBO 0.3

rusefillc, 2021-09-29:
this 121 board now references latest Hellen

We can migrate to WBO 0.3 but technically not required yet

rusefillc, 2021-10-01:
See https://github.com/andreika-git/hellen-one/blob/master/modules/wbo/changelog.md for migration notes "remove one track and refill"

rusefillc, 2021-10-04:
Let's NOT do this yet to reduce risks and effort

rusefillc, 2022-10-14:
Wonder what was risky here, is it a direct drop it with zero copper changes?

Thread 77 (2021-10-20):

Jumpers table for 2004 3.2

rusefillc, 2021-10-20:
Please fill in https://github.com/rusefi/rusefi/wiki/Hellen121VAG#vehicle-specific-jumpers for https://github.com/rusefi/rusefi/wiki/2004-Cayenne

Qwerty-OFF, 2021-10-31:
Updated
Please check that this is 12V_IGN powered by key
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

NMSTEC, 2021-10-31:
Confirmed this is IGN/Terminal 15 from kessy to ECU & other modules.
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

Closed 2021-10-31.

Thread 78 (2021-10-31):

Schematics usability: explicit VR_THRESHOLD net name on other end

rusefillc, 2021-10-31:
let's explicitly label E18 net on this part of schematics

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

Qwerty-OFF, 2022-10-14:
Fixed
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

Closed 2022-10-14.

Thread 82 (2021-12-17):

VAG 3.2 Cayenne/Golf-R/Touareg

NMSTEC, 2021-12-17:
Pinouts currently in TS are not only unmatched to this motor, but also cannot select correct options. Stuff I have found:

Crank sensor is hall on Pin 90
Engine stock has no MAP.
IAT is on pin 26
Cayenne has two fuel pumps, one controlled by pin 37 and the other by 65
APP is 34 & 36. In TS I can only select 34 & 35. In 3.2 case, 35 is APP gnd.
VSS is 38. Unable to select that in TS.

Ignition settings don't quite fit this specific motor. I assume we should have 3.2VR option for common settings, cause this would be fucky to any normal user.
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

Same goes for injectors
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

There is probably more, however thats as far as I got today. Will update when on vacation. Please resolve APP, and crank asap so I can test this on a live car. <3
[3.2 Cayenne ECU schem.pdf](https://github.com/rusefi/hellen121vag/files/7732064/3.2.Cayenne.ECU.schem.pdf)

Thread 83 (2021-12-17):

VAG 3.2 Cayenne/Golf-R/Touareg pedal position sensor drama

rusefillc, 2021-12-17:
Current rusEFI has no jumper provisions in this area - note it's GND SIG SIG GNS

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

And we have two wires flipped on https://github.com/rusefi/rusefi_documentation/blob/master/OEM-Docs/VAG/2004-cayenne-3.2-all.pdf

Note SIG GND SIG GND sequence

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

rusefillc, 2021-12-17:
@NMSTEC there is nothing software can do here at the moment. Please either modify wiring harness or modify hellen board

Will add provisions on the board for next revision

Thread 84 (2021-12-17):

3.2 6 cylinder CAM/CRANK

rusefillc, 2021-12-17:
https://github.com/rusefi/rusefi_documentation/blob/master/OEM-Docs/VAG/2004-cayenne-3.2-all.pdf

Does this engine have four camshafts?

Camshaft sensors 1 and 2. Are those VR or Hall? Which of the four cams are those?

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

rusefillc, 2021-12-17:
I really hope that diagram is fucked up

at least one typo here - note x1 of "camshaft sensor 1" and x3 of "camshaft sensor 2"

but also two of "engine speed" which does not match sensors

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

NMSTEC, 2021-12-17:
Discharge wave, intake wave is CAM, and is Hall.
Camshaft sensor 1 & 2 is solenoid.

It is indeed wrong Labelling. They use google translate from German. Please see my additions in Excel, as I've accounted for the errors.

NMSTEC, 2021-12-17:
Also this is not 3.2 V6. This is 3.2 VR6. Only one bank.

rusefillc, 2021-12-17:
@NMSTEC for now please wire crank into pin 54 which is VSS in TS at the moment

NMSTEC, 2021-12-17:
[3.2 vr6 touareg.pdf](https://github.com/rusefi/hellen121vag/files/7737158/3.2.vr6.touareg.pdf)
Slightly less shit diagram

Thread 85 (2022-02-11):

Vag 1.8t clutch pin 39

Mohammed3705, 2022-02-11:
When you use the (clutch pin 39) you will get pedal error.

rusefillc, 2022-02-11:
@Mohammed3705 please provide much more details

ideally upload bad tune to https://rusefi.com/online/ and please link the tune with bad configuration

please paste screenshot of error message

rusefillc, 2022-10-14:
closing since no response :(

Closed 2022-10-14.

Thread 88 (2022-10-18):

IMPORTANT MCU 0.7 is still work in progress

rusefillc, 2022-10-18:
Reminder that we shall either use MCU 0.6 or wait for MCU 0.7 release

rusefillc, 2022-10-23:
Status update: https://github.com/andreika-git/hellen-one/issues/171 at least PCB part of the change is done

@Qwerty-OFF can you please update to latest hellen and give 0.7 MCU a try (176 package on this 121vag right?)

rusefillc, 2023-03-20:
Things have changed again we now live in mm universe :)

rusefillc, 2023-04-03:
#90 would take care of it

Closed 2023-04-03.

Thread 89 (2023-03-07):

Evaluate KiCAD 7

rusefillc, 2023-03-07:
What does KiCAD 7 mean for us?

Can we please "convert" this board just as an example into KiCAD 7 if there is such thing as KiCAD7? Let's go as far as export artifacts and try the complete hellen workflow on those new artifacts

chuckwagoncomputing, 2023-03-09:
I'm keeping an eye on Kicad 7. Looks like I don't have the ability to assign this to myself.

chuckwagoncomputing, 2023-03-15:
When I open this board with Kicad 7, I get some components off the side of the board.
Could someone confirm whether this is the case with older versions?
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

rusefillc, 2023-03-30:
https://github.com/rusefi/alphax-4chan already uses kicad7

Closed 2023-03-30.

Thread 90 (2023-03-30):

update schematics to mega

rusefillc, 2023-03-30:

Nadezhda-n, 2023-03-31:
Also _vr-discrete_ and _wbo_?

rusefillc, 2023-03-31:
> Also **vr-discrete** and **wbo**?

Yes please!

Nadezhda-n, 2023-04-03:
Это ревизия D?

rusefillc, 2023-04-03:
> Это ревизия D?

Yep looks like we are working on rev-D at the moment

Nadezhda-n, 2023-04-05:
Я прошу проверить, верно ли я сделала вот это:
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

rusefillc, 2023-04-05:
SD&accel точно верно, синий блок давай сотрём
# unused очень мутное слово, давай уточним про что это всё-таки и почему

если про не-монтаж второй кан шины, то бесопаснее и мудрее не монтировать только главный чип за доллар, а рассыпуху проще монтировать

Nadezhda-n, 2023-04-05:
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

Именно про это и спрашивала, так и записала
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

Nadezhda-n, 2023-04-05:
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

убрала все изменения в этом файле

Thread 91 (2023-04-05):

replace resistors rev D

Nadezhda-n, 2023-04-05:
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

Thread 98 (2025-08-15):

I had never done F1 removal. Two ECUs cannot control MREL

ElDominio, 2025-08-15:
Does running F1+F2 cause damage to _something_? Two ECUs cannot control main relay after F1 removal. One was stuck to ground (and fried ULN2003), another was stuck high. We forced pin21 to ground and the car ran, until we removed.

Replacing ULN2003 that smoked only got stuck high and did not drive the relay, while on the bench setting "default inverted" definitely provides ground on pin21, but not enough to drive a relay _somehow_

ElDominio, 2025-08-15:
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

Fixed
