rusefi/hellen121vag/boards/hellen121vag-c/board/hellen121vag-c-schematic.pdf

OUT_IO10 E10 OUT_IO9 E11 OUT_IO2 E12 OUT_IO12 E13 OUT_PWM2 E14 OUT_PWM3 E15 OUT_PWM4 E16 OUT_PWM5 E17 OUT_PWM6 E18 OUT_PWM7 E19 OUT_IO11 E20 OUT_IO7 E21 OUT_IO8 E22 OUT_IO4 E23 OUT_IO13 E24 OUT_INJ1 E25 OUT_INJ2 E26 OUT_PWM1 E27 OUT_PWM8 E28 OUT_INJ3 E29 OUT_INJ4 E30 OUT_INJ5 E31 OUT_INJ6 E32 OUT_INJ7 E33 OUT_INJ8 E34 OUT_IO3 E6 OUT_IO5 E7 OUT_IO1 E8 OUT_IO6 E9 OUT_IGN1 W1 OUT_IGN2 W2 OUT_IGN3 W3 OUT_IGN4 W4 OUT_IGN5 W5 OUT_IGN6 W6 OUT_IGN7 W7 OUT_IGN8 W8M3BModule-mcu-0.5 SPI1_SCK

# E2 SPI1_MOSI E3 SPI1_CS1 E4 SPI1_CS2 E5 CAN_VIO

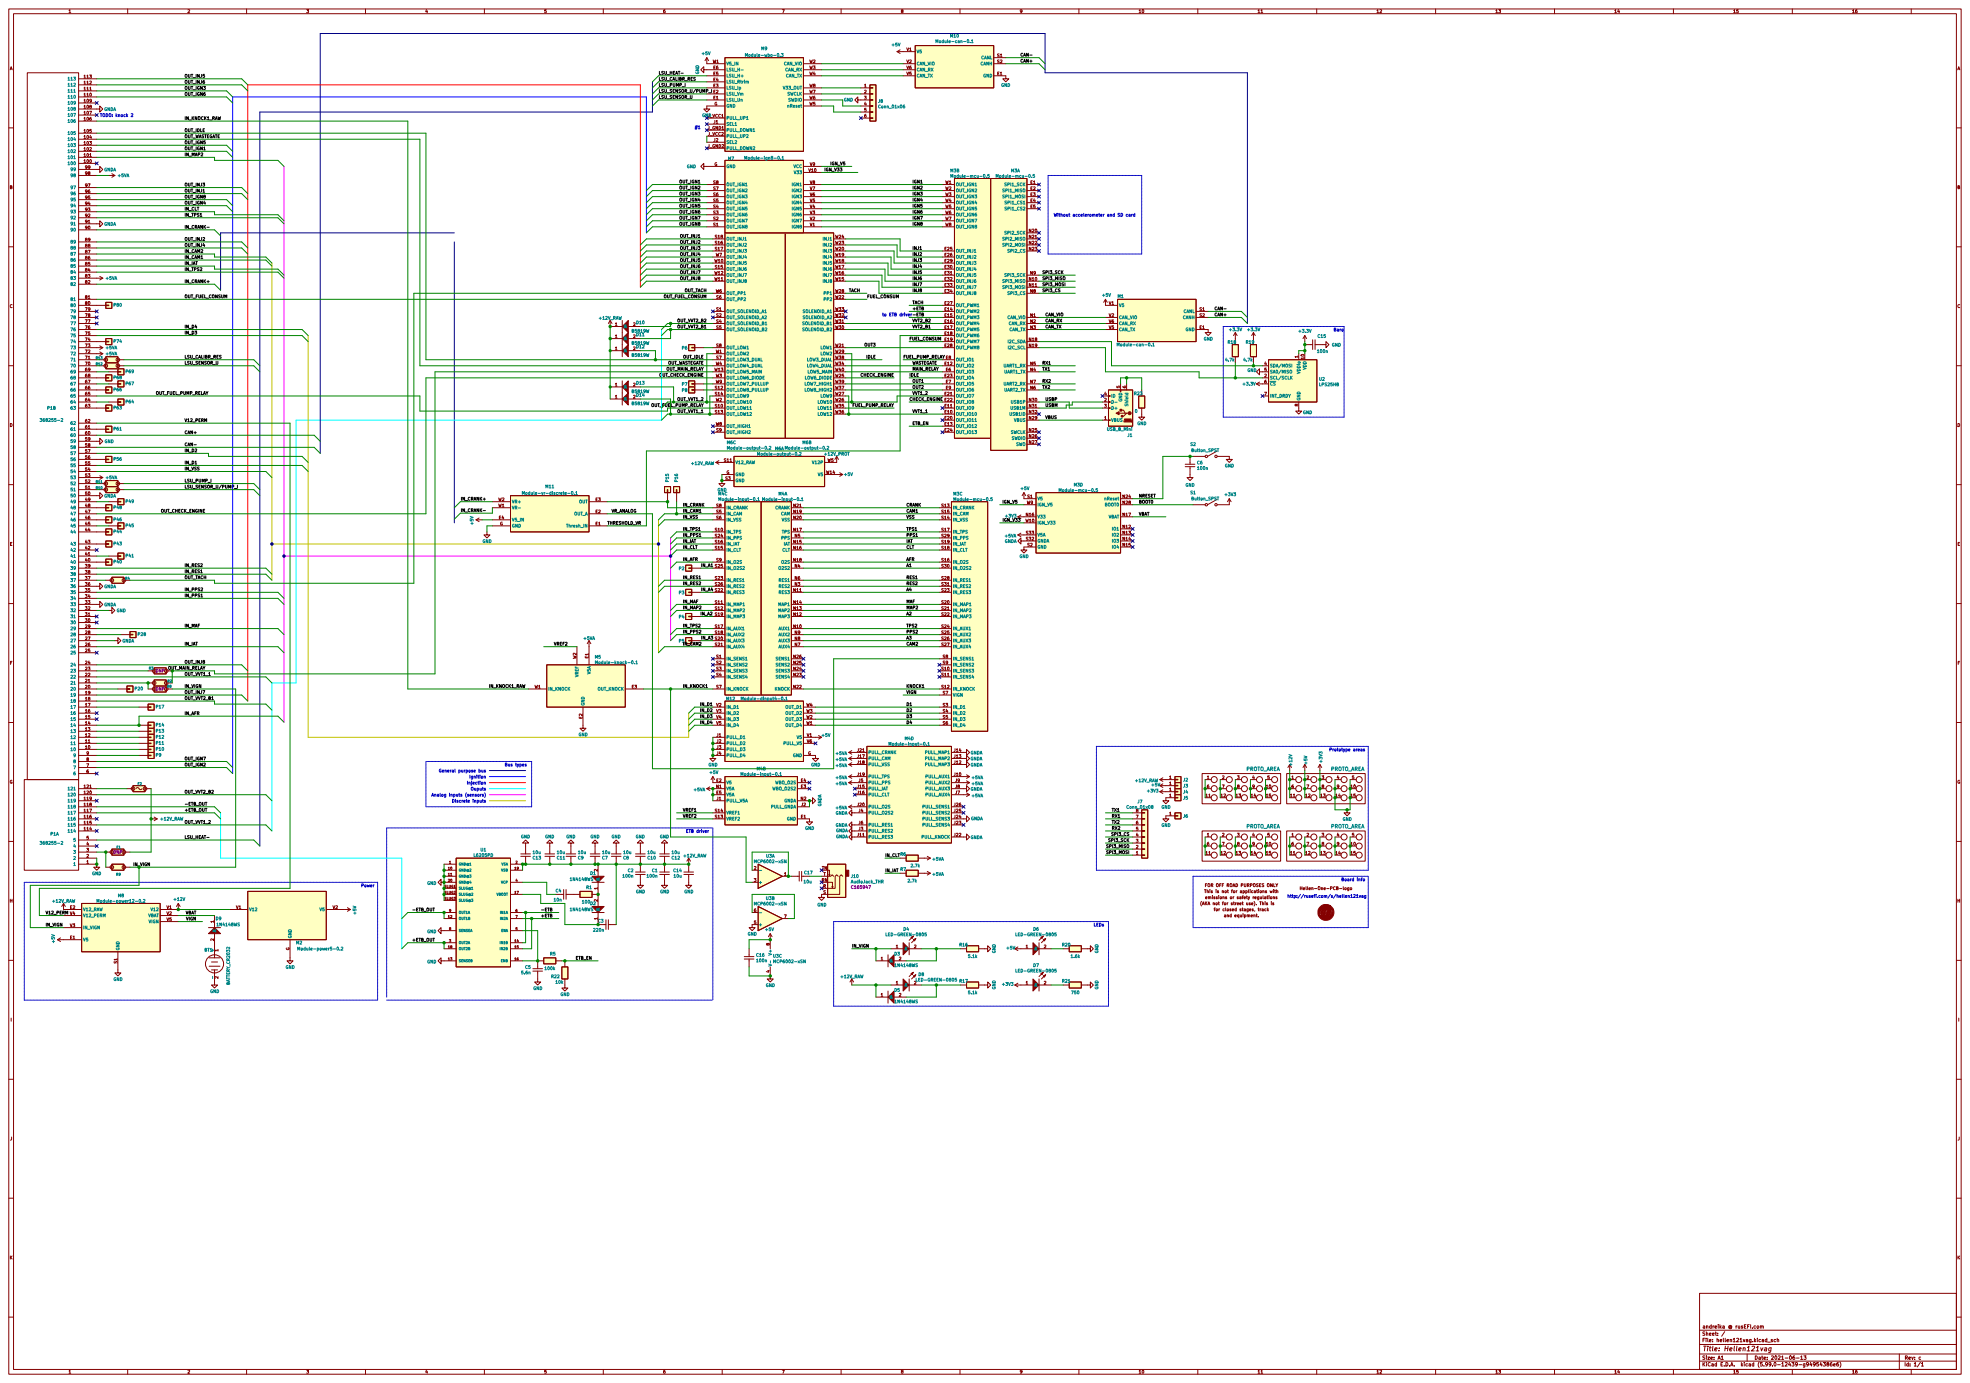
[picture p14: page 1]

Without accelerometer and SD card

http://rusefi.com/s/hellen121vag Board info Discrete inputs

for closed stages, track FOR OFF ROAD PURPOSES ONLY
This is not for applications with
emissions or safety regulations
(AKA not for street use). This is

Hellen-One-PCB-logo

andreika; Size:; Author:; Date:; Revision:; Sheet; PESD1CAN; GND; CANH; CANL; TXD 1 GND 2 VCC 3; Vio; 5 RXD 4; 6 CANH; TJA1051T/3/1J; CANH CANL; CAN_TX; CAN_RX; CAN_VIO; CAN_VIO V2; S2 CANL; CAN_TX V5; CAN_RX V6; Module:can/0.1

Hellen-One CAN
Title:

rusEFI EMS
Hellen-One Platform
https://rusefi.com/s/hellen72

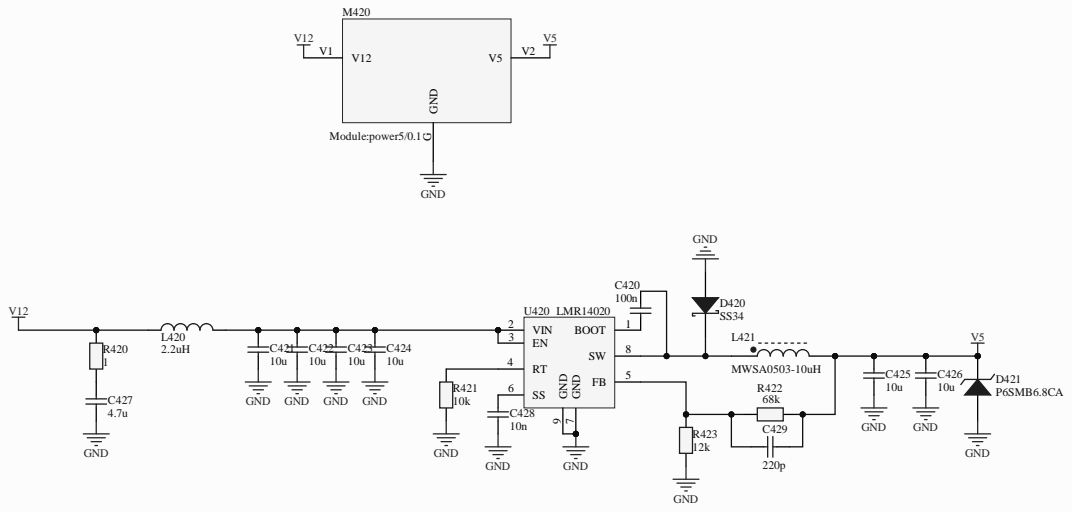
[picture p16: page 3]

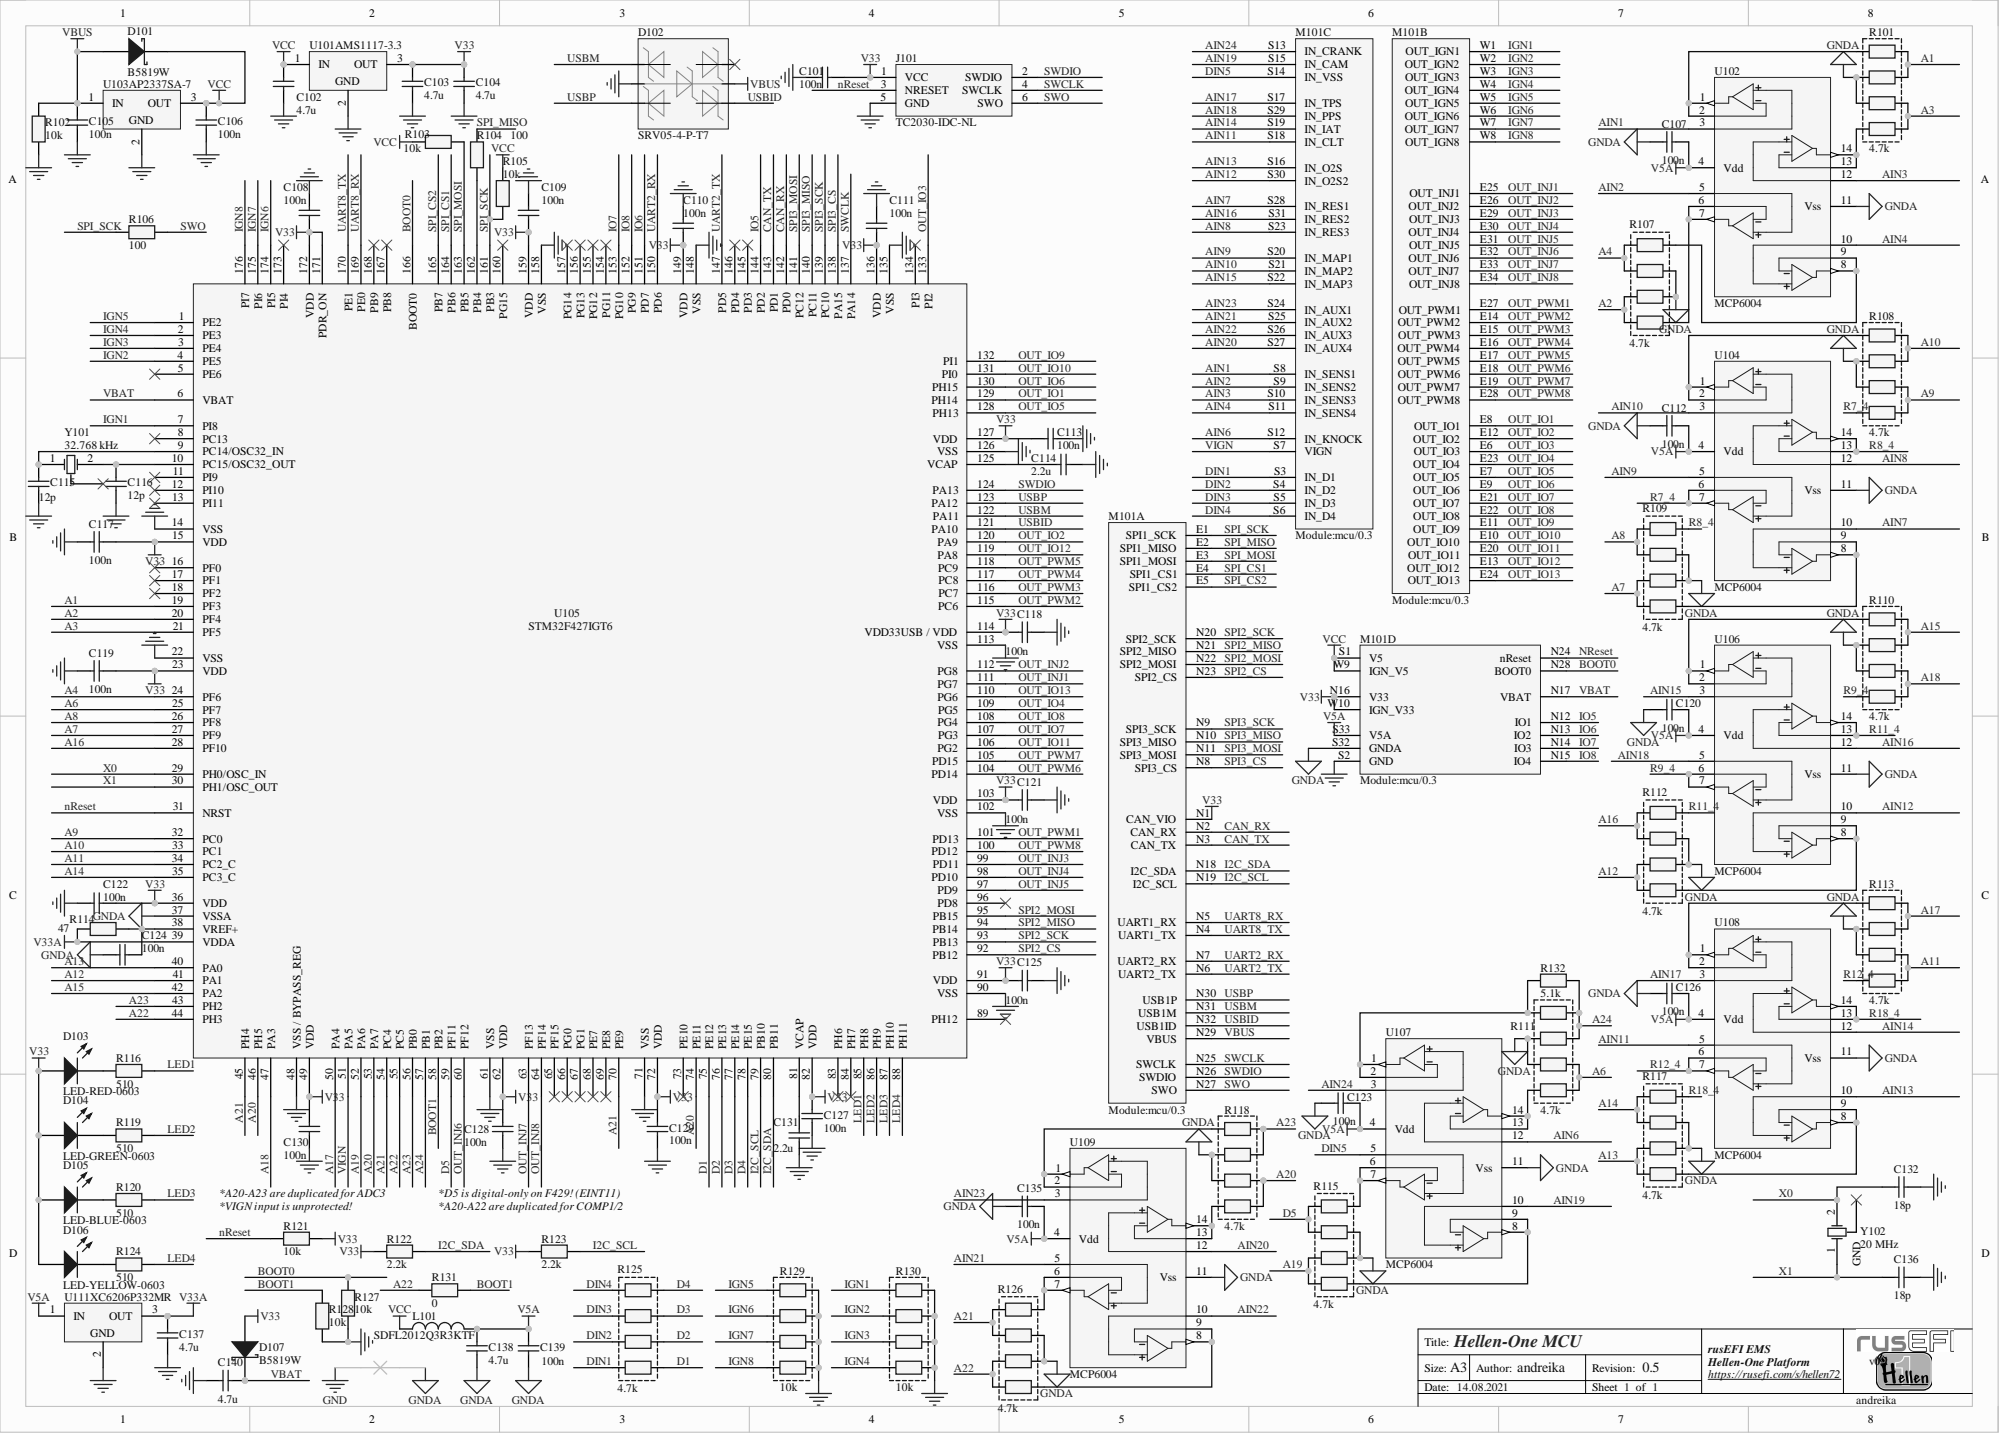
[picture p17: page 4]

D5 *D5 is digital-only on F429!(EINT11)

*A20-A23 are duplicated for ADC3
*VIGN input is unprotected!

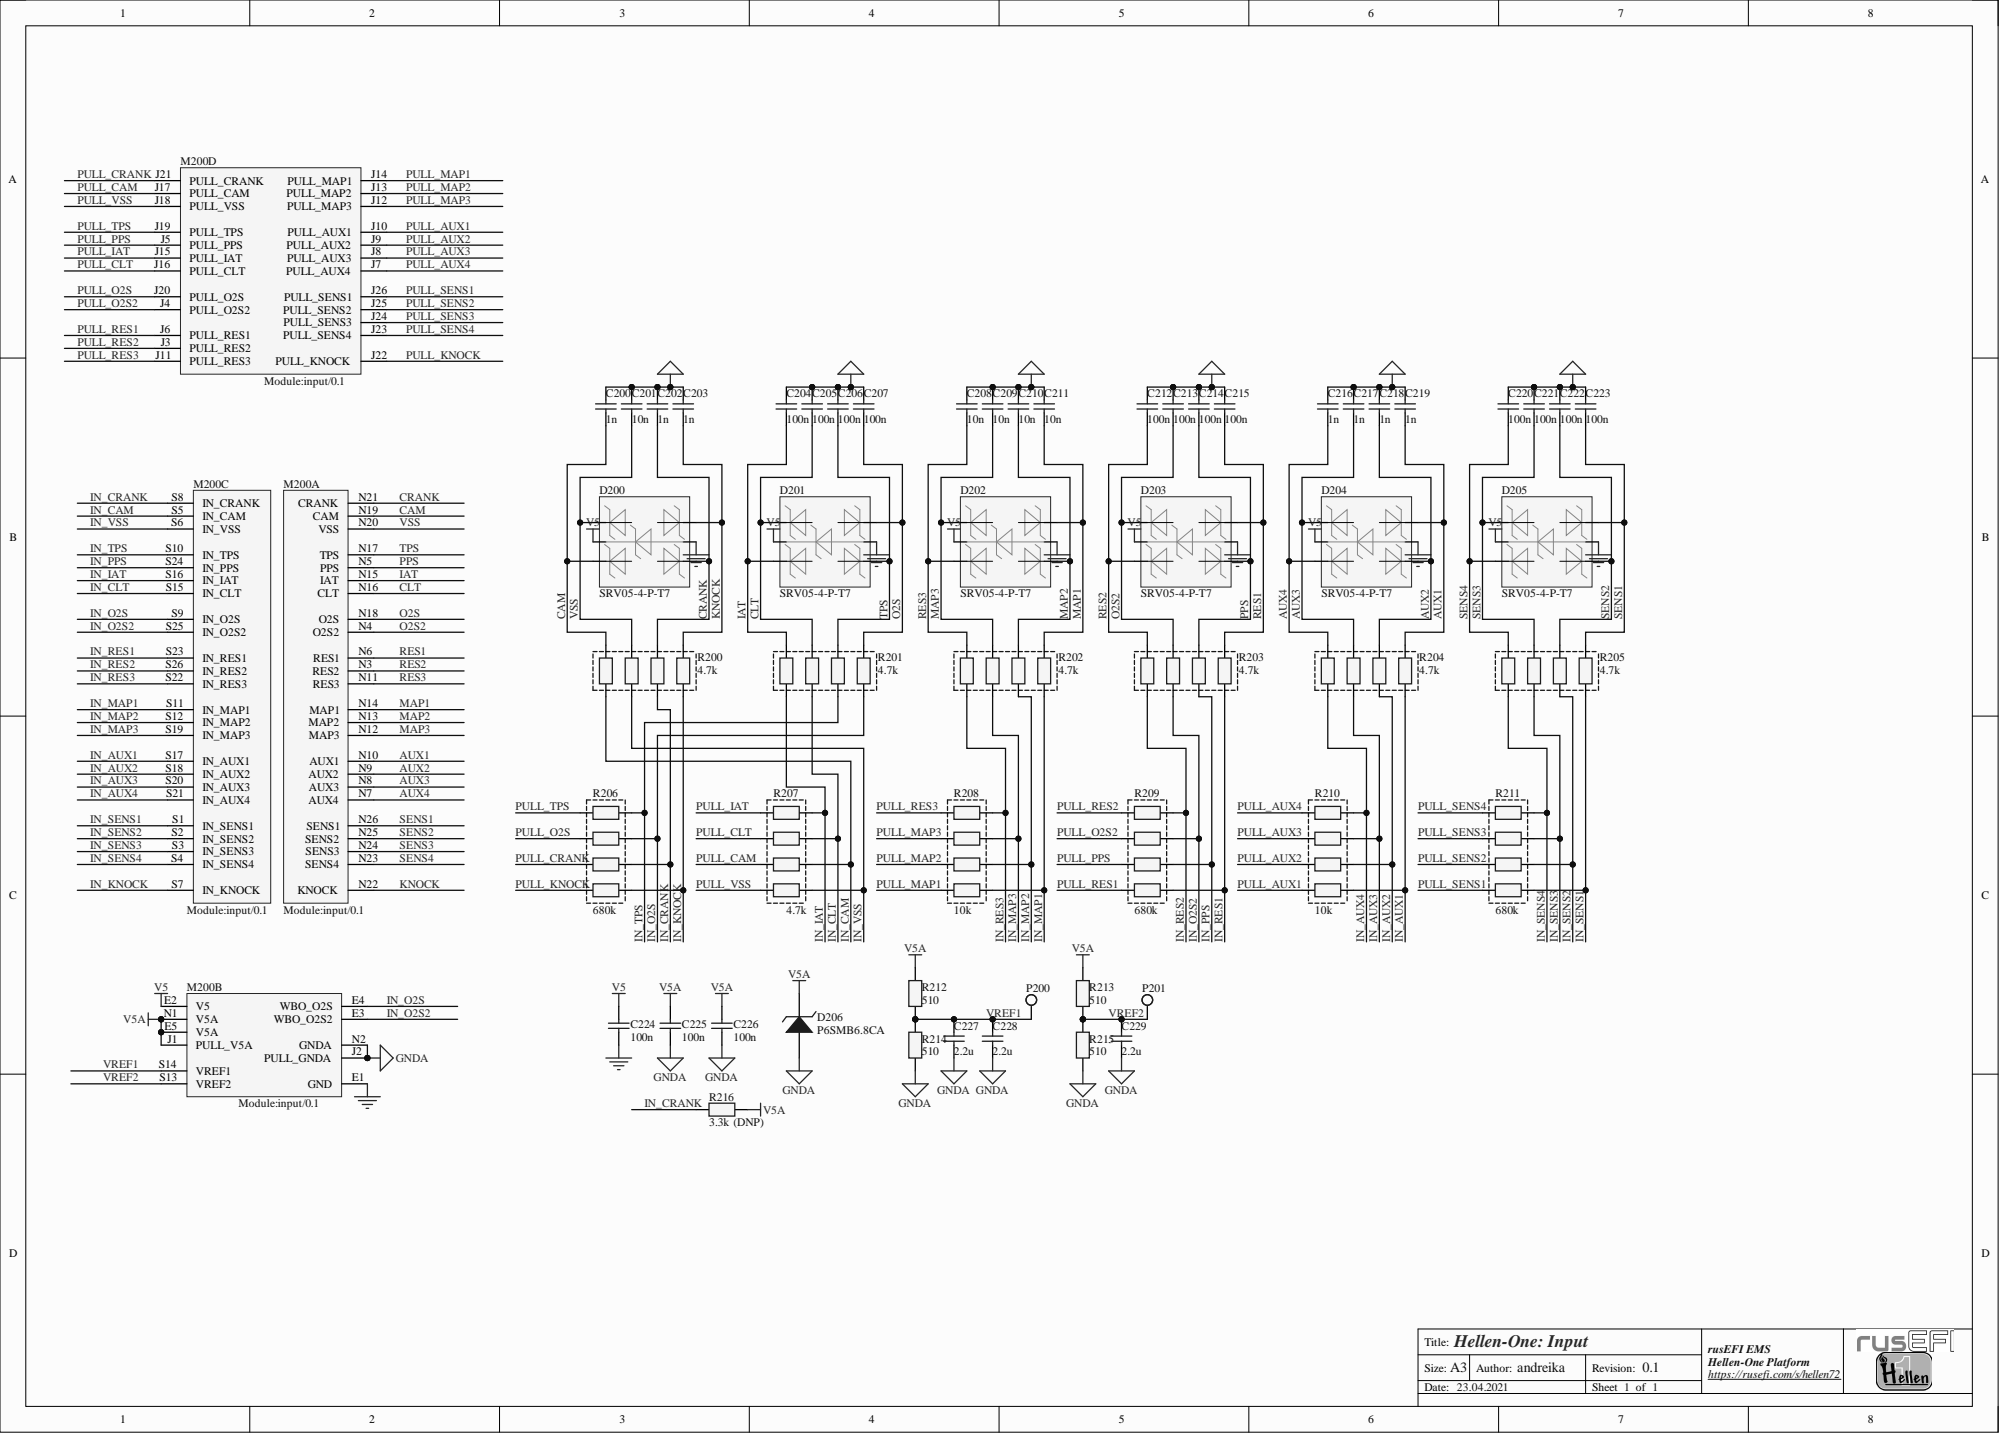
[picture p18: page 5]

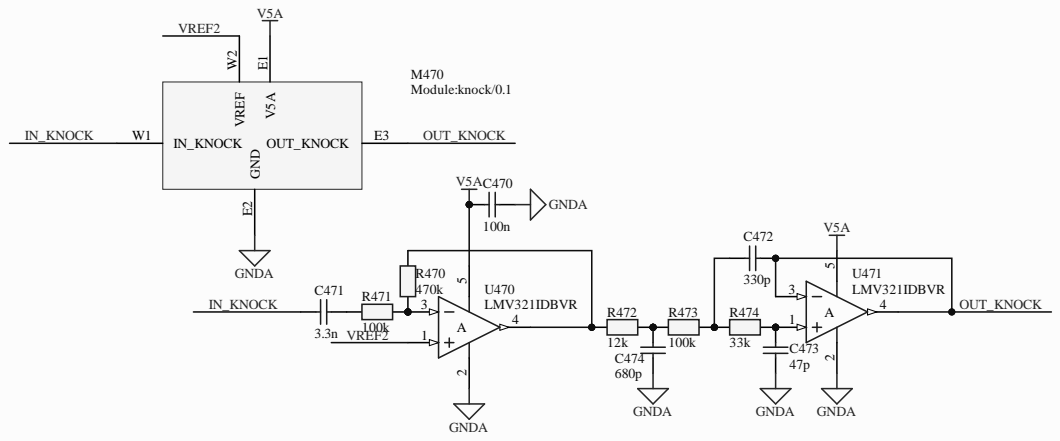
[picture p19: page 6]

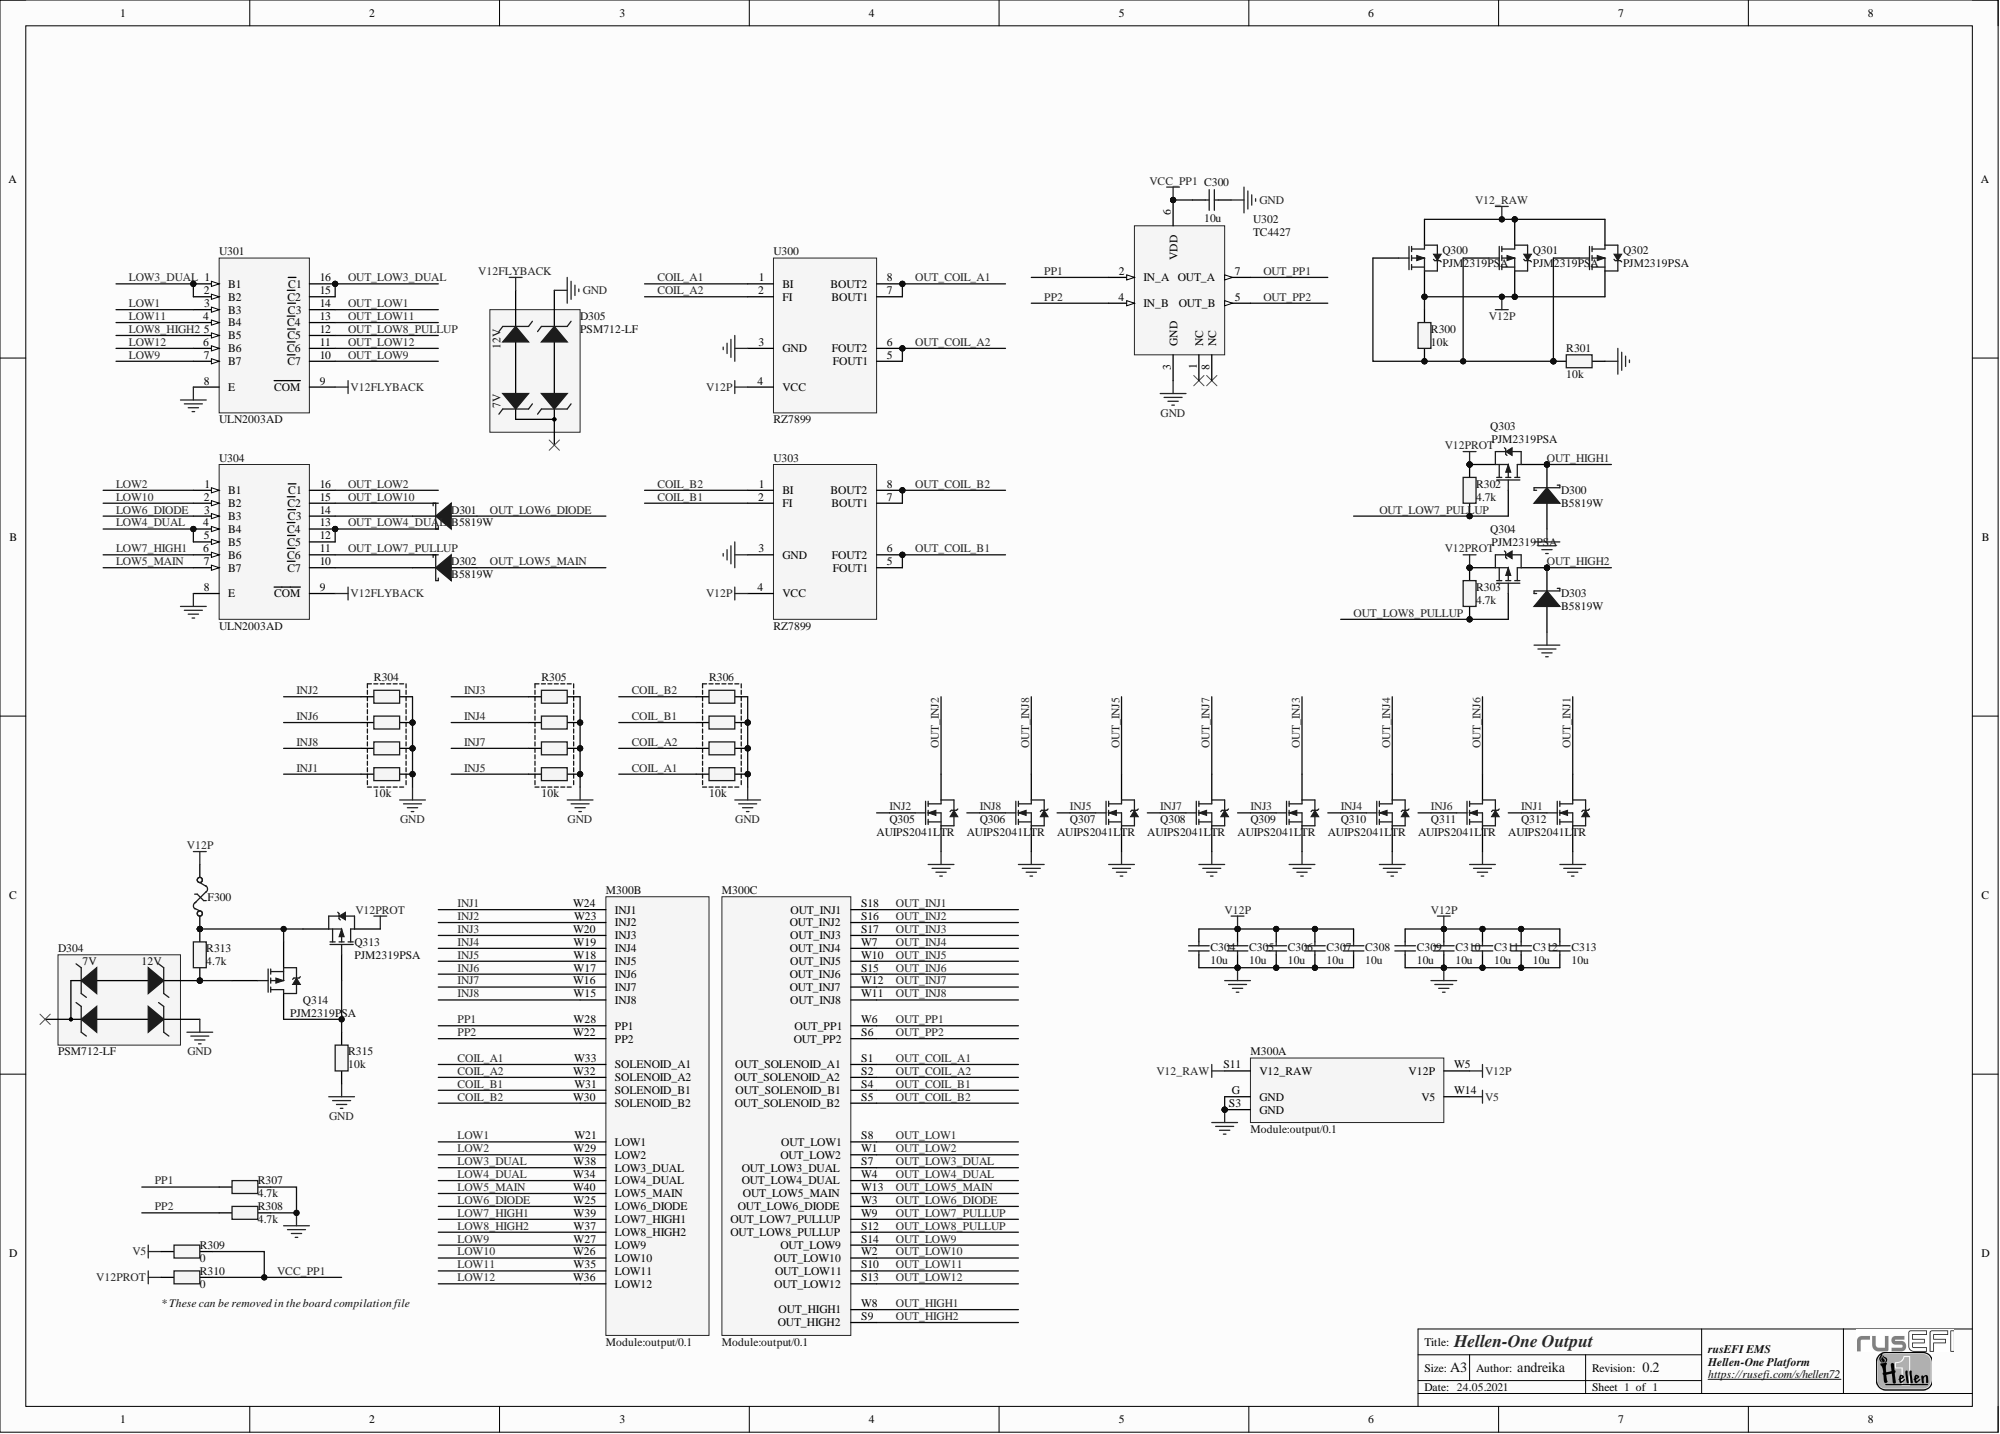
[picture p20: page 7]

* These can be removed in the board compilation file

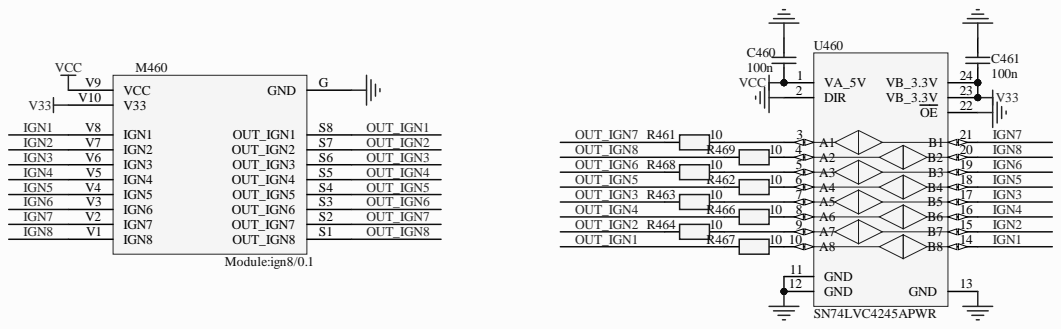
[picture p21: page 8]
tfo rm m/s/h; Size:; Rev; Shee; VCC; APW

Hellen-One IGN8 andreika

rusEFI EMS https://rusefi.co
Hellen-One

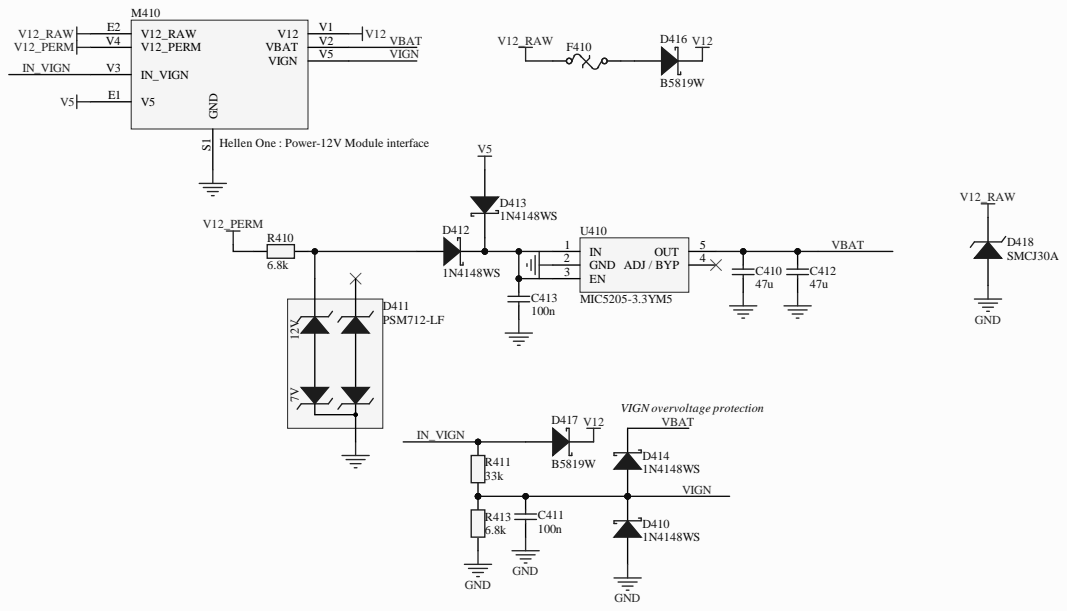
[picture p22: page 9]
tfo rm m/s/h; Hellen-One Power1 2; dreik; Size:; Rev; Shee; VBA; GND S1; Hel; len O; wer-1; terface; VIGN; overvo; tect; 8 SMCJ; 1 PSM7; MIC5

rusEFI EMS https://rusefi.co
Hellen-One

1kR600

3.3k R623

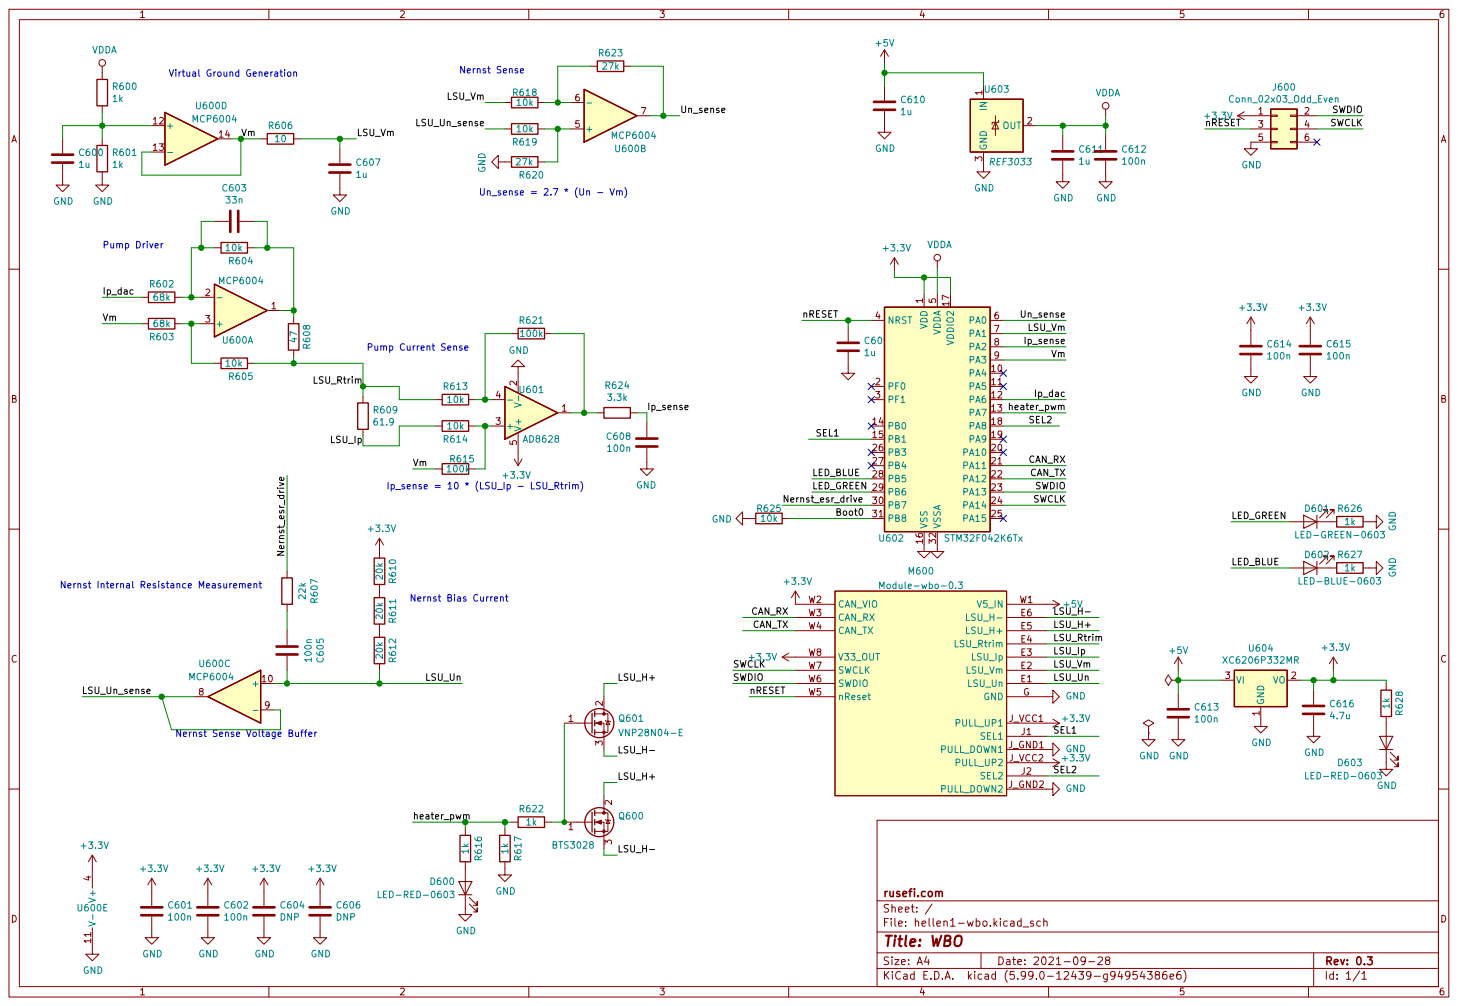
[picture p23: page 10]

Pump Current Sense Nernst Sense

LSU_Vm
Pump Driver Nernst Internal Resistance Measurement

1 VO 2 VI 3 U604 XC6206P332MR GND GND

1 PA4 10 PA5 11 PA6 12 PA7 13 PB0 14 PB1 15 VSS 16 VDDIO2 17 PA8 18 PA9 19 PF0 2 PA10 20 PA11 21 PA12 22 PA13 23 PA14 24 PA15 25 PB3 26 PB4 27 PB5 28 PB6 29 PF1 3 PB7 30 PB8 31 VSSA 32 NRST 4 VDDA

LED-RED-0603 ¹⁰⁰n C⁶⁰⁵ C604 DNP

Nernst Sense Voltage Buffer

1k GND GND R⁶¹⁶ ¹k

File: hellen1-wbo.kicad_sch Sheet: / rusefi.com

# +5V GND

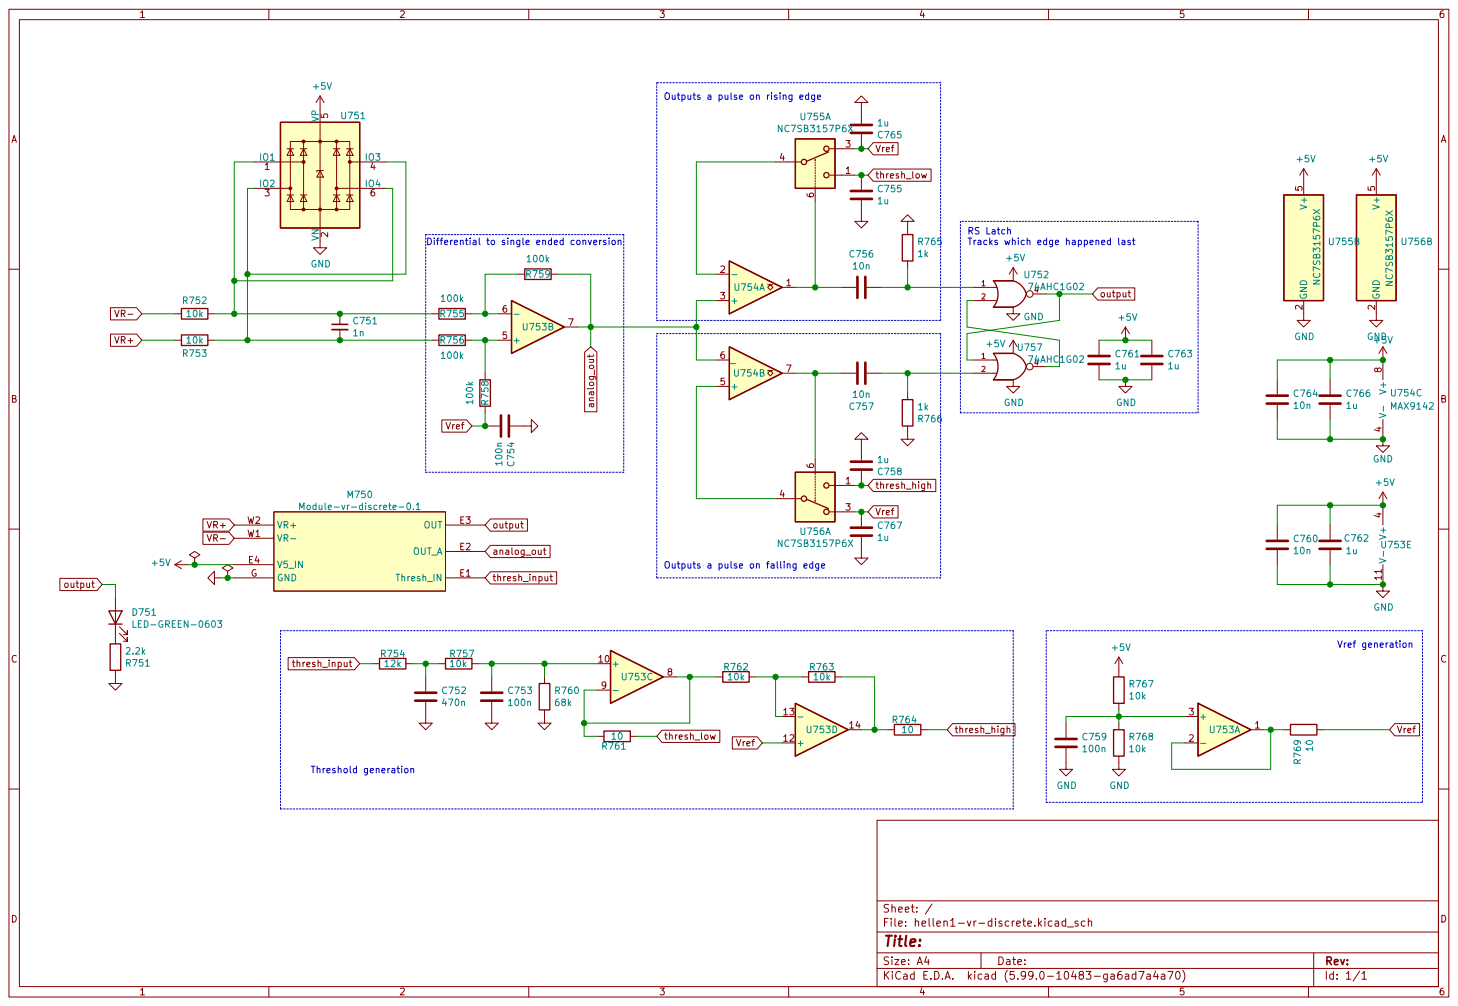
[picture p24: page 11]

Outputs a pulse on falling edge

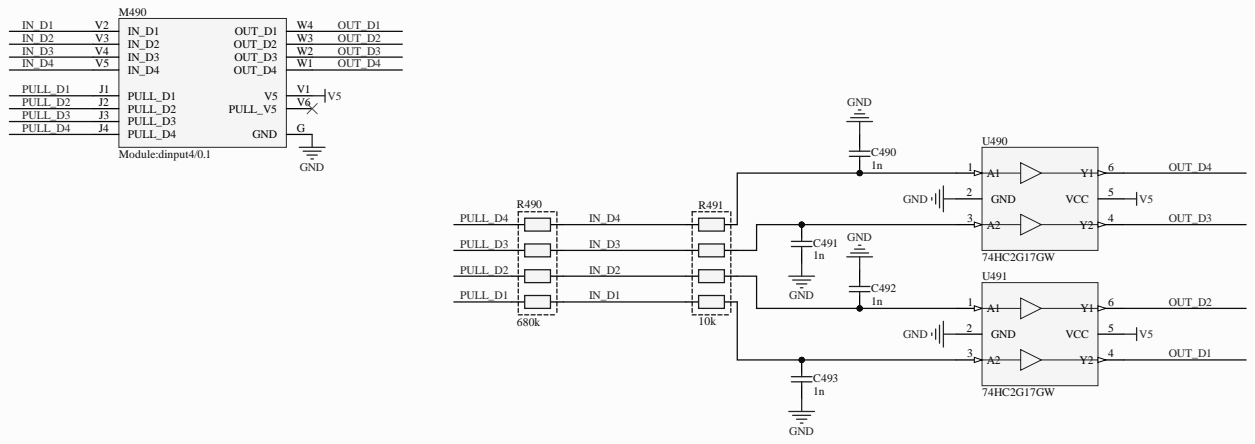
[picture p25: page 12]
tfo rm m/s/h; Size:; Rev; Shee; VCC

Hellen-One VR andreika

rusEFI EMS https://rusefi.co
Hellen-One
