rusefi/hellen121vag/boards/hellen121vag-b/board/hellen121vag-b-schematic.pdf

# E2 SPI1_MOSI E3 SPI1_CS1 E4 SPI1_CS2 E5 CAN_VIO

# I2C_SCL N19 CAN_RX N2 SPI2_SCK N20 SPI2_MISO

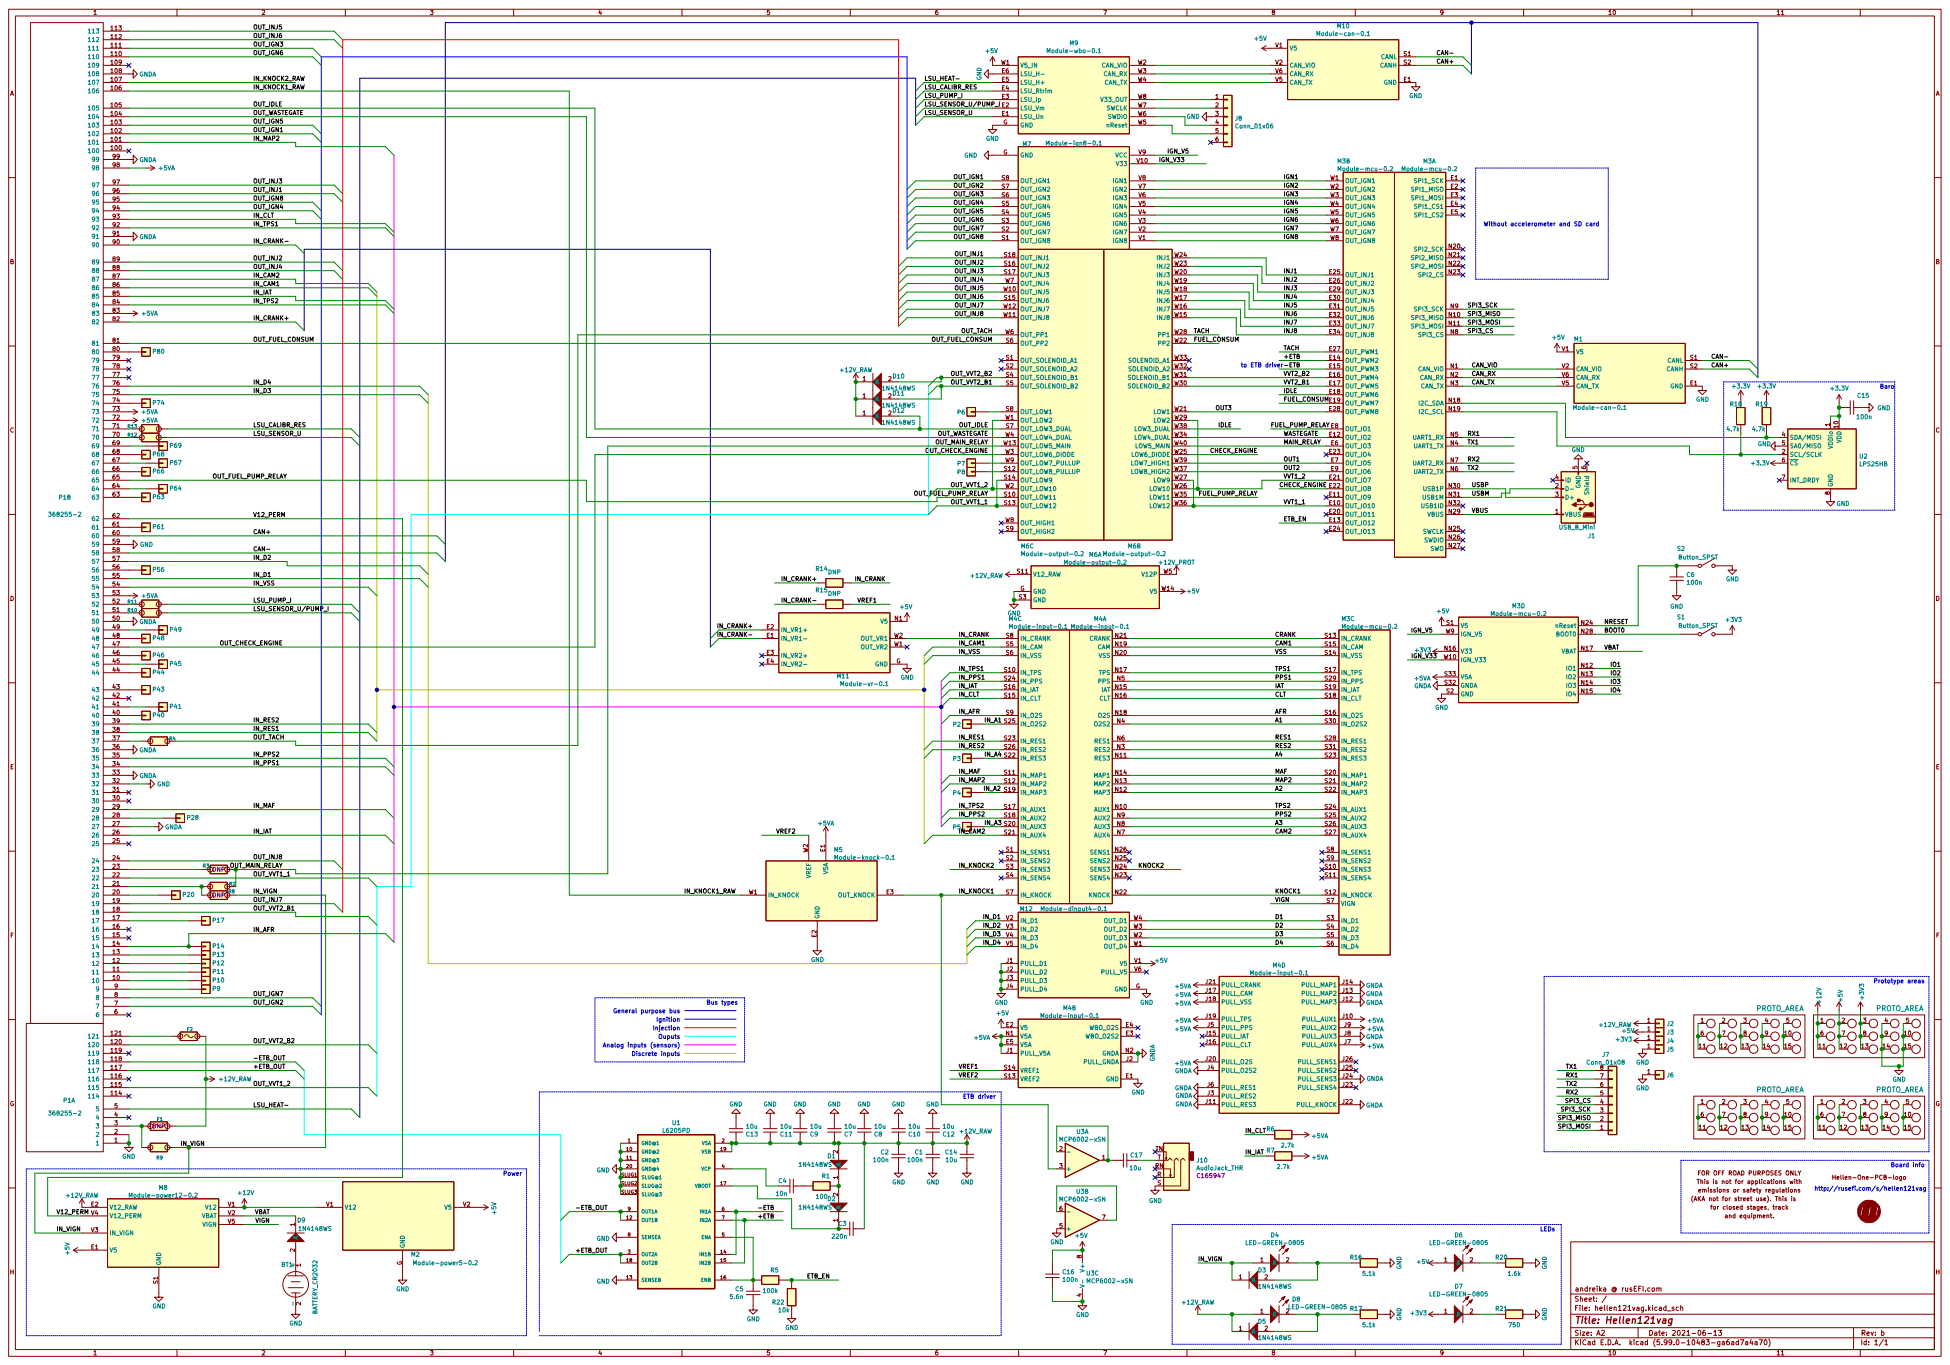
[picture p26: page 1]

Without accelerometer and SD card

IAT N15 CLT N16 TPS N17 O2S N18 CAM N19 VSS N20 CRANK N21 KNOCK N22 SENS4 N23 SENS3 N24 SENS2 N25 SENS1 N26 RES2 N3 O2S2 N4 PPS N5 RES1 N6 AUX4 N7 AUX3 N8 AUX2 N9 M4A Module-input-0.1

for closed stages, track FOR OFF ROAD PURPOSES ONLY

This is not for applications with GND

emissions or safety regulations
(AKA not for street use). This is

File: hellen121vag.kicad_sch Sheet: / andreika @ rusEFI.com

andreika; Size:; Author:; Date:; Revision:; Sheet; PESD1CAN; GND; CANH; CANL; TXD 1 GND 2 VCC 3; Vio; 5 RXD 4; 6 CANH; TJA1051T/3/1J; CANH CANL; CAN_TX; CAN_RX; CAN_VIO; CAN_VIO V2; S2 CANL; CAN_TX V5; CAN_RX V6; Module:can/0.1

Hellen-One CAN
Title:

rusEFI EMS
Hellen-One Platform
https://rusefi.com/s/hellen72


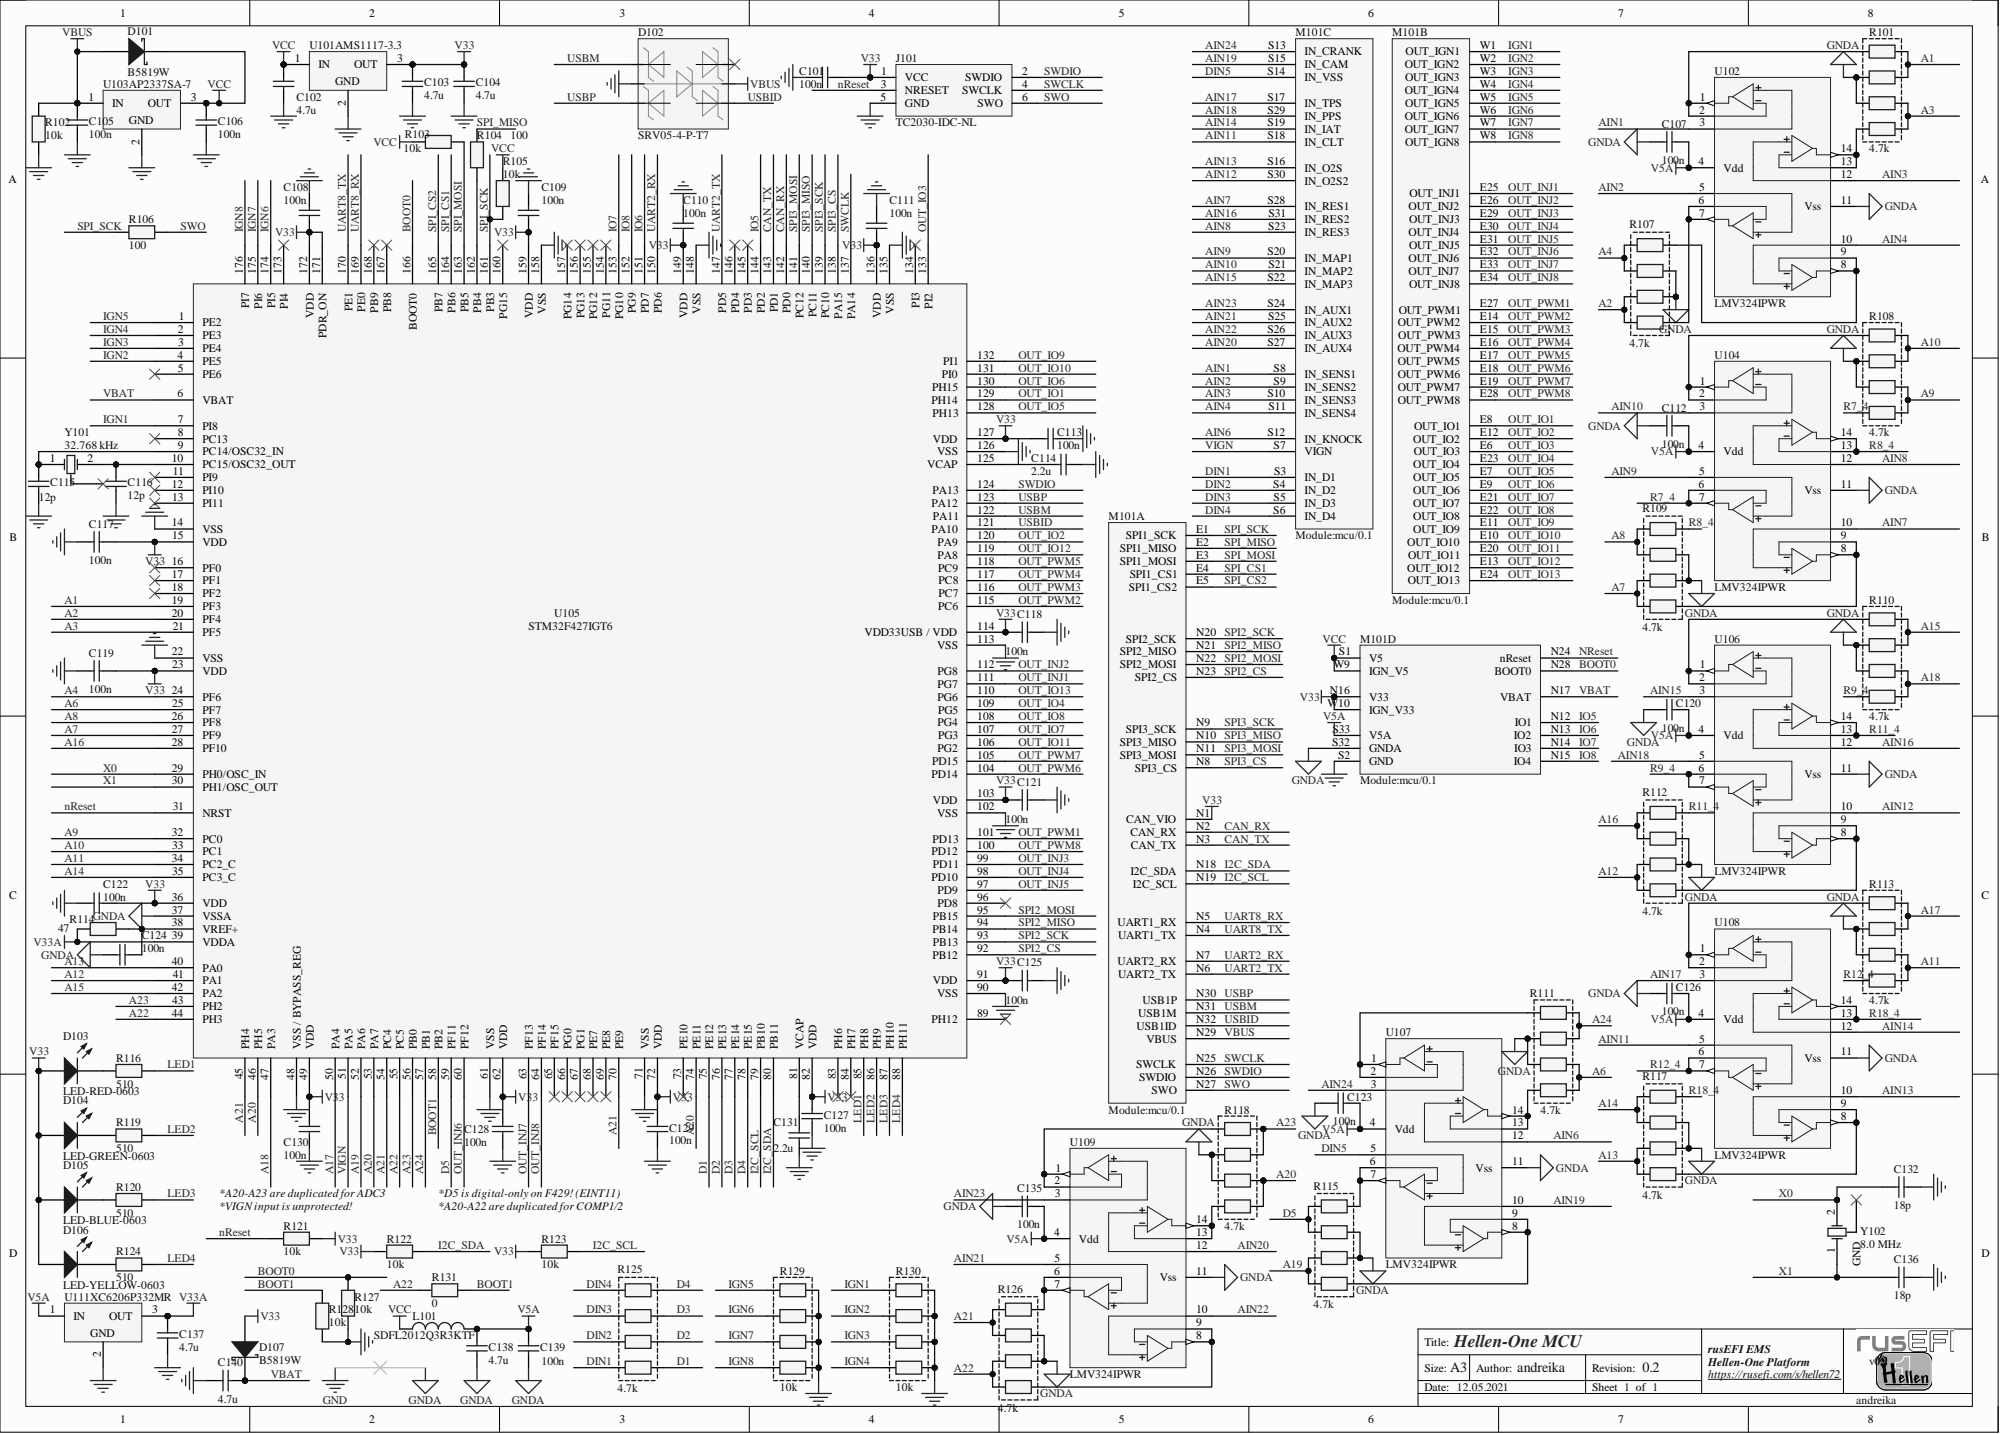
[picture p27: page 4]

D5 *D5 is digital-only on F429!(EINT11)

*A20-A23 are duplicated for ADC3
*VIGN input is unprotected!




* These can be removed in the board compilation file

tfo rm m/s/h; Size:; Rev; Shee; VCC; APW

Hellen-One IGN8 andreika

rusEFI EMS https://rusefi.co
Hellen-One

tfo rm m/s/h; Hellen-One Power1 2; dreik; Size:; Rev; Shee; VBA; GND S1; Hel; len O; wer-1; terface; VIGN; overvo; tect; 8 SMCJ; 1 PSM7; MIC5

rusEFI EMS https://rusefi.co
Hellen-One

# +3.3V IN

100k C607

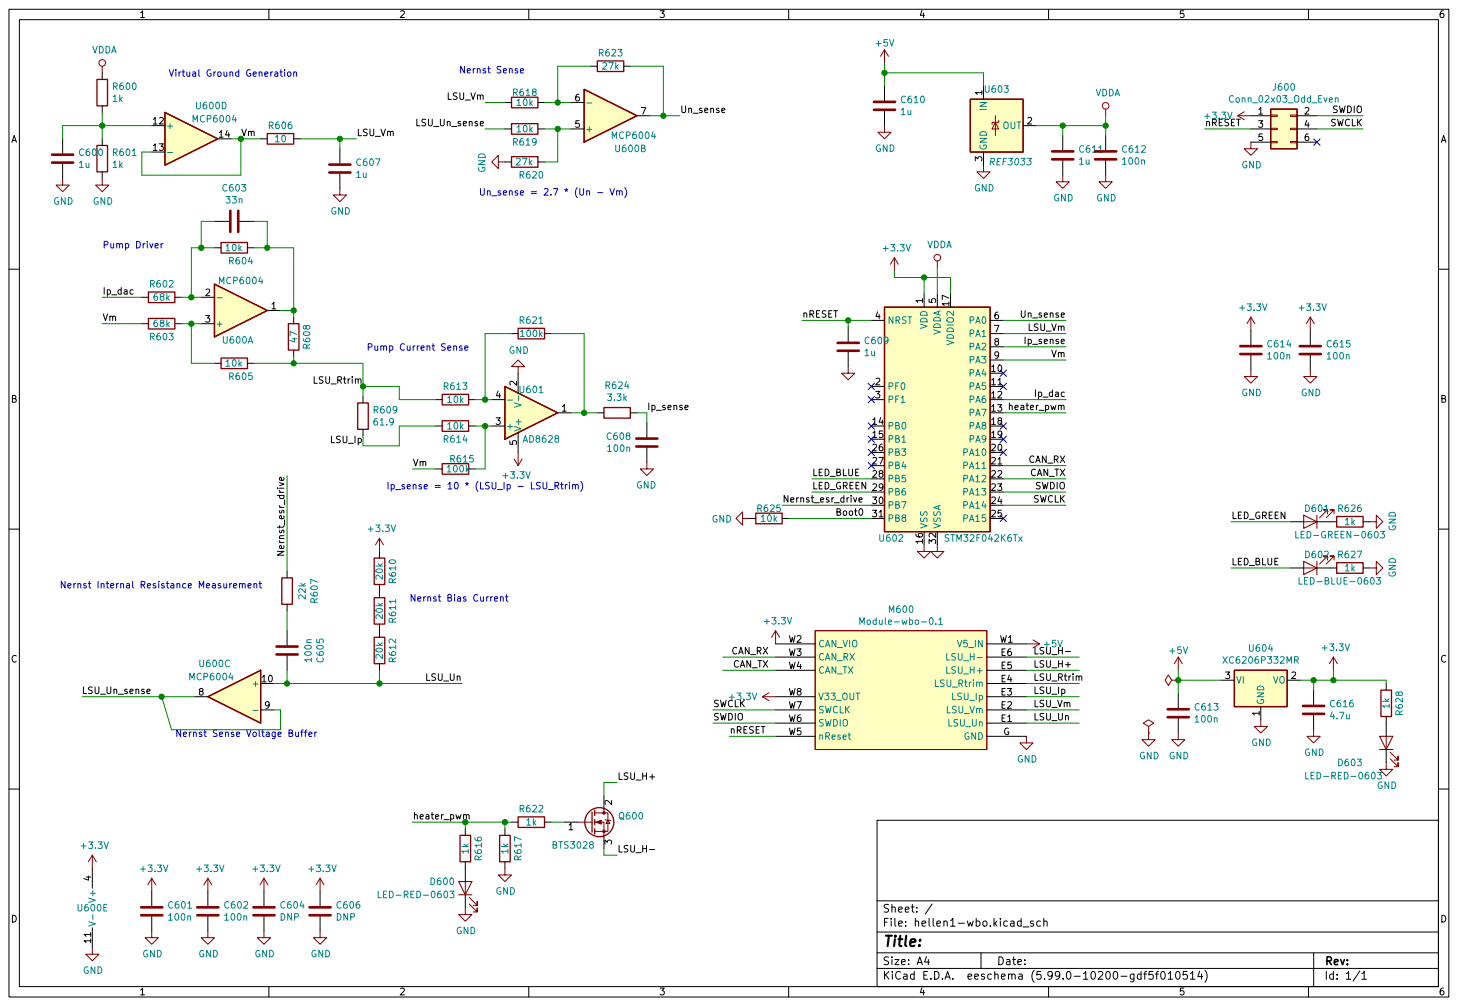
[picture p28: page 10]

1 PA4 10 PA5 11 PA6 12 PA7 13 PB0 14 PB1 15 VSS 16 VDDIO2 17 PA8 18 PA9 19 PF0 2 PA10 20 PA11 21 PA12 22 PA13 23 PA14 24 PA15 25 PB3 26 PB4 27 PB5 28 PB6 29 PF1 3 PB7 30 PB8 31 VSSA 32 NRST 4 VDDA

File: hellen1-wbo.kicad_sch Sheet: / GND

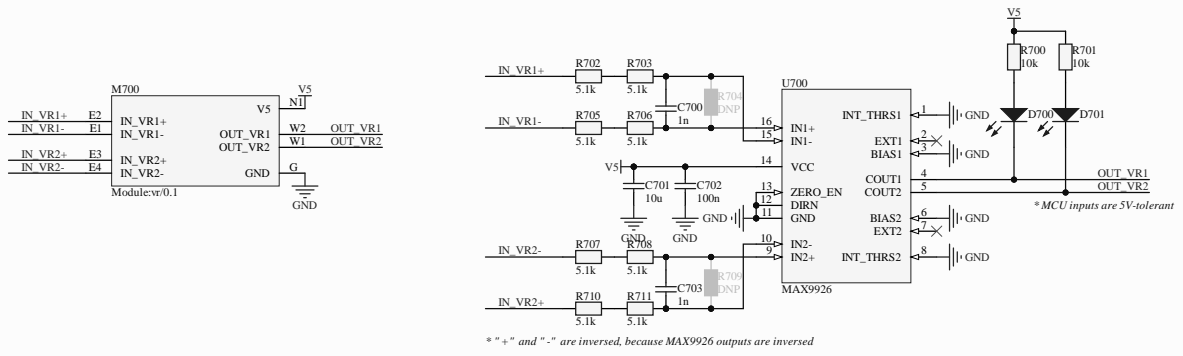
[picture p29: page 11]

* MCU inputs are 5V-tolerant

* " +" and " -" are inversed, because MAX9926 outputs are inversed

tfo rm m/s/h; Size:; Rev; Shee; VCC

Hellen-One VR andreika

rusEFI EMS https://rusefi.co
Hellen-One
