rusefi/hellen121vag/(commit log)

2021-01-29 starting point
    [board_vag_121.kicad_pcb]
2021-02-10 initial 121vag-a files
    [121vag-BOM.csv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]
2021-02-14 fresh kicad files
    [hellen121vag.csv, hellen121vag.kicad_pcb, hellen121vag.kicad_sch]
2021-02-20 update kicad files
    [hellen121vag.kicad_pcb, hellen121vag.kicad_sch]
2021-02-21 update all
    [121vag-BOM.csv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]
2021-02-23 update kicad files after mod.refactoring
    [hellen121vag.kicad_pcb, hellen121vag.kicad_sch]
2021-03-13 wbo added
    [hellen121vag.kicad_pcb, hellen121vag.kicad_sch]
2021-03-13 Start adding vr module into 121...
    [hellen121vag.kicad_sch]
2021-03-15 Use vr module
    [hellen121vag.kicad_pcb, hellen121vag.kicad_sch]
2021-03-23 Move BOM replacements to a separate csv file https://github.com/rusefi/hellen121vag/issues/7
    [bom_replace_121vag-a.csv]
2021-04-13 Dinput4 + proto areas
    [hellen121vag.kicad_pcb, hellen121vag.kicad_sch]
2021-04-13 Conector silk
    https://github.com/rusefi/hellen121vag/issues/13
    [hellen121vag.kicad_pcb]
2021-04-16 Minor Bike Shed Improvement: command line gerber export? #24
2021-04-16 Upd pcb, sch
    Power5 0.2
    turn connector
    bridge driver is almost complete
    [hellen121vag.kicad_pcb, hellen121vag.kicad_sch]
2021-04-17 ETB driver power input
    [hellen121vag.kicad_pcb, hellen121vag.kicad_sch]
2021-04-17 Improved usability
    [hellen121vag.kicad_pcb, hellen121vag.kicad_sch]
2021-04-23 Refactor sch
    [hellen121vag.kicad_sch]
2021-04-24 New modules schematics, baro, SWD-WBO
    [hellen121vag.kicad_pcb, hellen121vag.kicad_sch]
2021-04-25 Knock audio
    [hellen121vag.kicad_pcb, hellen121vag.kicad_sch]
2021-04-27 Moving scripts
    [121vag-BOM.csv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]
2021-04-27 Upd replace
    [121vag-CPL.csv, 121vag.DRL, 121vag.GBL, 121vag.GBO, 121vag.GBS, 121vag.GKO, 121vag.GTL, 121vag.GTO]
2021-04-27 Upd h1
    [121vag-BOM.csv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]
2021-04-30 fix https://github.com/andreika-git/hellen-one/issues/33
    [hellen121vag-a.GBL, hellen121vag-a.GBO, hellen121vag-a.GBS, hellen121vag-a.GKO, hellen121vag-a.GTL, hellen121vag-a.GTO, hellen121vag-a.GTP, hellen121vag-a.GTS]
2021-05-01 Fabrication outputs
    [121vag-BOM.csv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]
2021-05-01 Notes area
    [121vag.DRL, 121vag.GBL, 121vag.GBO, 121vag.GBS, 121vag.GKO, 121vag.GTL, 121vag.GTO, 121vag.GTP]
2021-05-01 Fix LCSC parts
    [bom_replace_121vag-a.csv, hellen121vag-a-BOM.csv]
2021-05-02 Fab time! Let's see how it goes :)
    [hellen121vag-a-BOM.02May2021.csv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]
2021-05-18 New vrml
    [121vag-BOM.csv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]
2021-05-19 update 3d models & vrml
    [hellen121vag.kicad_pcb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]
2021-05-19 fix some footprint names for iBom
    [121vag-BOM.csv, bom_replace_121vag-b.csv, hellen121vag-b-BOM.csv]
2021-05-20 new folder structure
    [hellen121vag-B_Cu.gbl, hellen121vag-B_Mask.gbs, hellen121vag-B_Silkscreen.gbo, hellen121vag-Edge_Cuts.gm1, hellen121vag-F_Cu.gtl, hellen121vag-F_Mask.gts, hellen121vag-F_Paste.gtp, hellen121vag-F_Silkscreen.gto]
2021-05-20 Fix paths
    [hellen121vag.kicad_sch]
2021-06-05 Upd sch: #25, #27, #28, #33, #34, #36, #37 and new versions of modules
    [hellen121vag.kicad_pcb, hellen121vag.kicad_sch]
2021-06-09 #40, #43
    [hellen121vag.kicad_pcb, hellen121vag.kicad_sch]
2021-06-13 Rev. b is fixed rev. a
    [121vag-BOM.csv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]
2021-06-14 Trying to fab rev B #46
    [hellen121vag-b-BOM.csv]
2021-06-14 Trying to fab rev B fix #46
    [hellen121vag-b-BOM.14june2021.csv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]
2021-08-23 Add TP
    [hellen121vag.kicad_pcb, hellen121vag.kicad_sch]
2021-08-24 Implement & Document trigger HW solder hookup pins #48
    [hellen121vag.kicad_pcb, hellen121vag.kicad_sch]
2021-09-08 less crazy routing for ignition outputs fix #32 Better match injector traces fix #45 Convert to 4 layer fix #56 Connect J1-6 USB cable shield to GND fix #62
    [hellen121vag.kicad_pcb, hellen121vag.kicad_sch]
2021-09-29 replace VR module with VR-discrete
    [hellen121vag.kicad_pcb, hellen121vag.kicad_sch]
2021-09-29 rev C
    [bom_replace_121vag-c.csv]
2021-10-08 DRC warnings. Silk under module under copper. VVT diode.
    [hellen121vag.kicad_pcb, hellen121vag.kicad_sch]
2021-10-11 rev. c fab time?
    [121vag-BOM.csv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]
2021-10-12 F1 DNP fix
    [121vag-BOM.csv, hellen121vag-c-BOM.csv, hellen121vag.csv]
2022-05-21 Auto-generated board
    [121vag-BOM.csv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]
2022-10-14 Upd PCB
    [hellen121vag.kicad_pcb, hellen121vag.kicad_sch]
2022-10-14 [skip actions] Auto-generated board
    [hellen121vag-d-CPL.csv, hellen121vag-d.DRL, hellen121vag-d.GBL, hellen121vag-d.GBS, hellen121vag-d.GKO, hellen121vag-d.GTL, hellen121vag-d.GTO, hellen121vag-d.GTP]
2023-03-20 VAG ibom rendering issue https://github.com/andreika-git/hellen-one/issues/82
    [hellen121vag.kicad_pcb]
2023-03-20 fix pcb image offset
2023-04-05 update schematics to mega, also knock & power #90
    [bom_replace_hellen121vag-d.csv, hellen121vag.kicad_sch]
2023-04-05 reverse changes
    [bom_replace_hellen121vag-d.csv]
2023-06-26 postponing rev D
    [121vag-BOM.csv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]
2024-06-13 fab C #92
    [hellen121vag-c-BOM.csv]
