rusefi/hellen121vag/(notices)

Notices in the files:
hellen121vag.kicad_pcb:
© andreika, 2021
